Dylanfg123/Zebra-X/Pics/Zynq_Boot_Modes.png

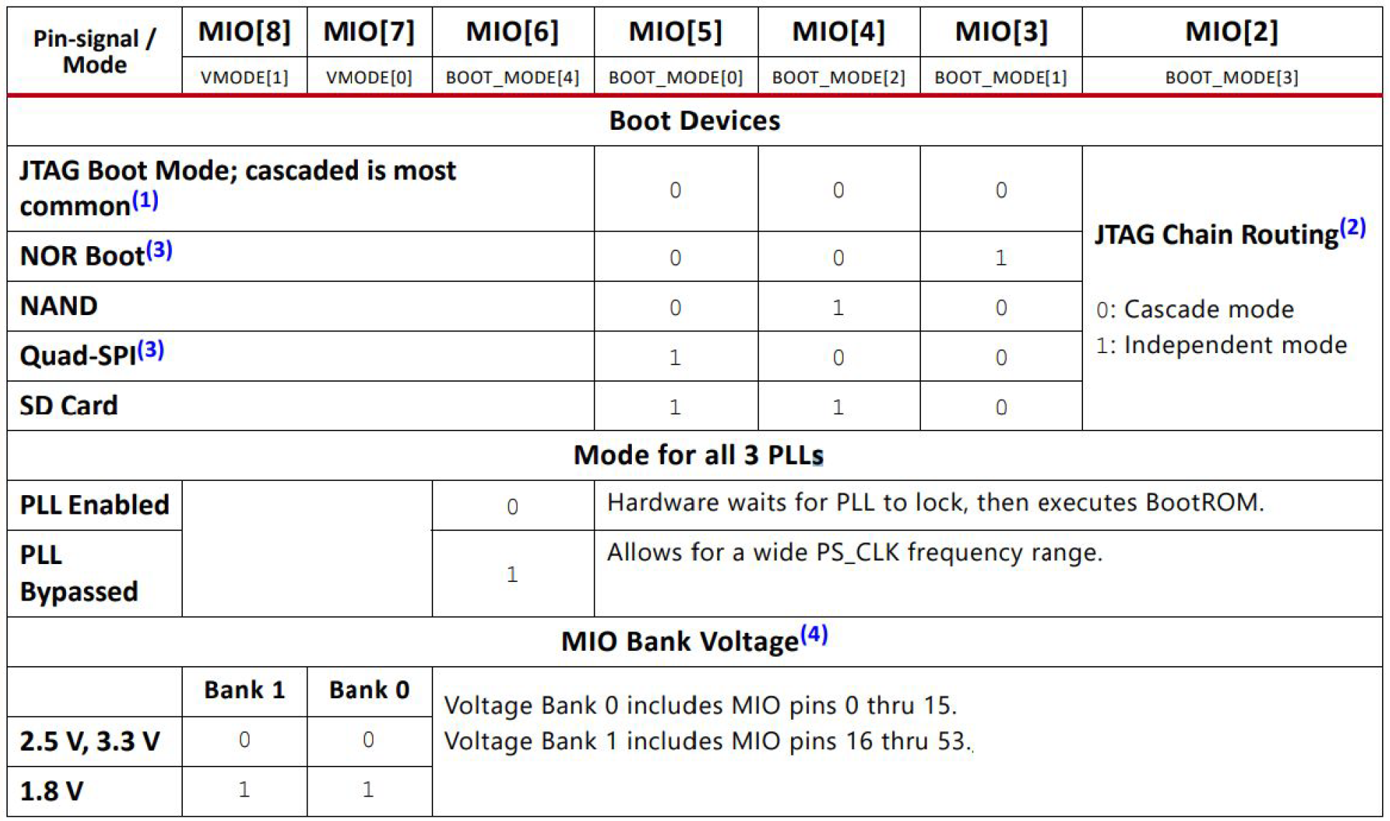
Pics/Zynq_Boot_Modes.png
