Dylanfg123/Zebra-X/Pics/Zynq_Required_PCB_Caps_PL.png

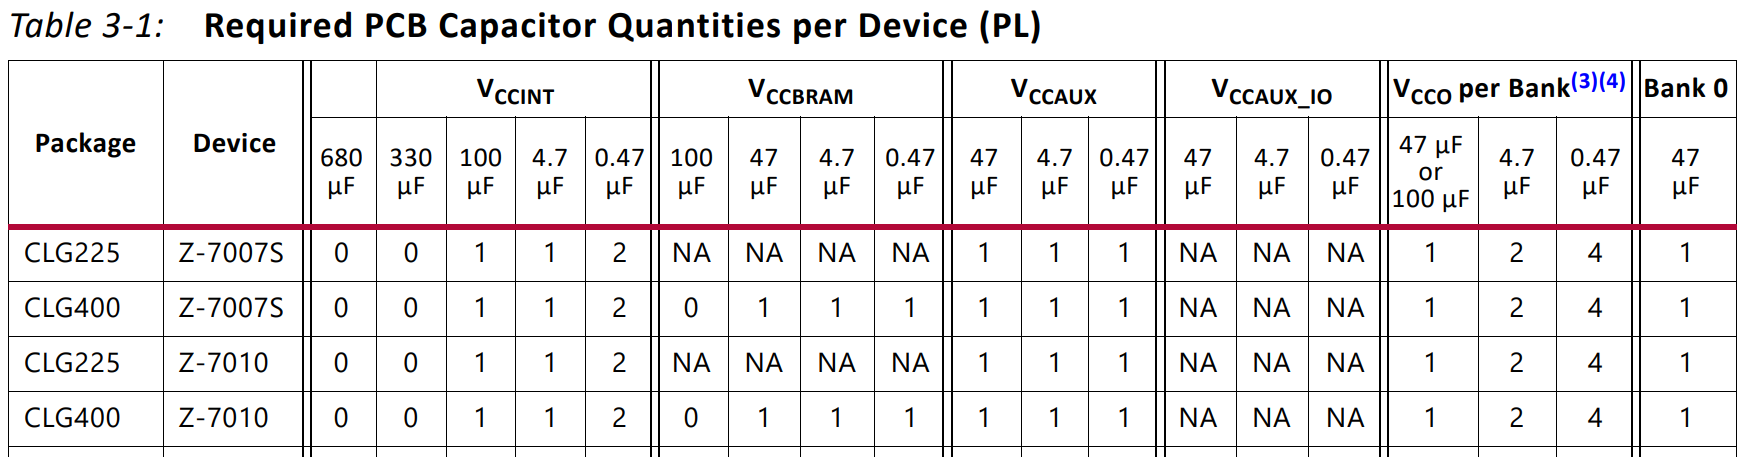
Pics/Zynq_Required_PCB_Caps_PL.png
