Dylanfg123/Zebra-X/Pics/Zynq_Required_PCB_Caps_PS.png

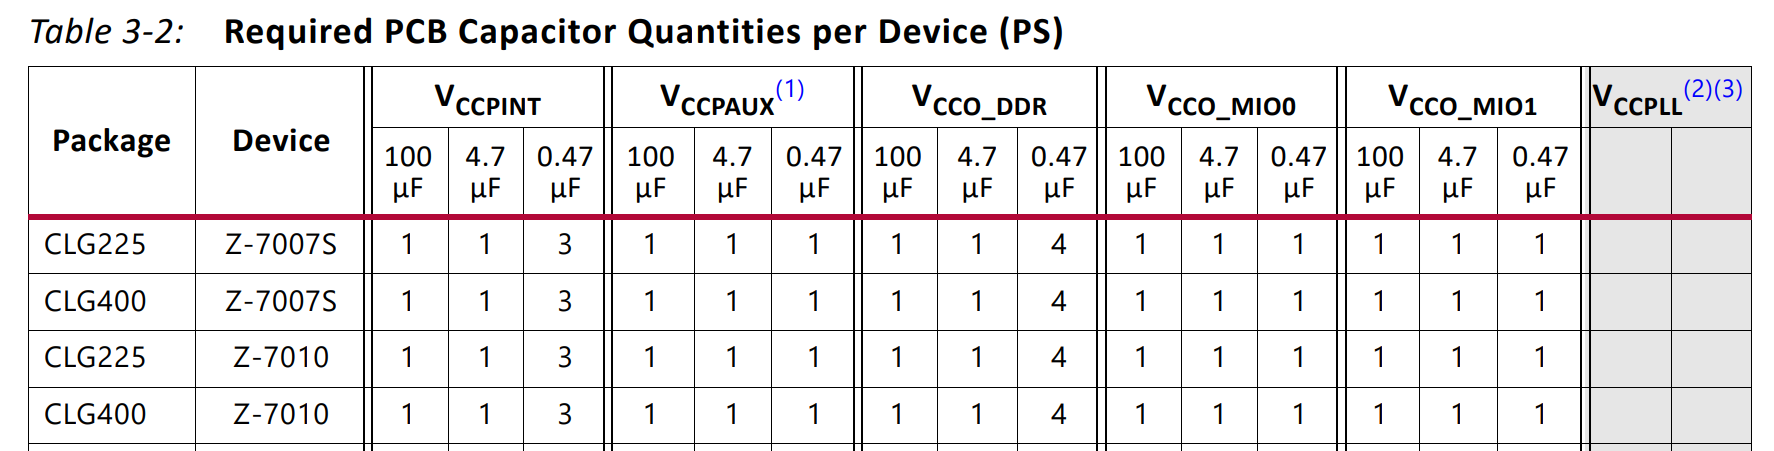
Pics/Zynq_Required_PCB_Caps_PS.png
