Dylanfg123/Zebra-X/3D_Models/GMSB0522132EU.stp

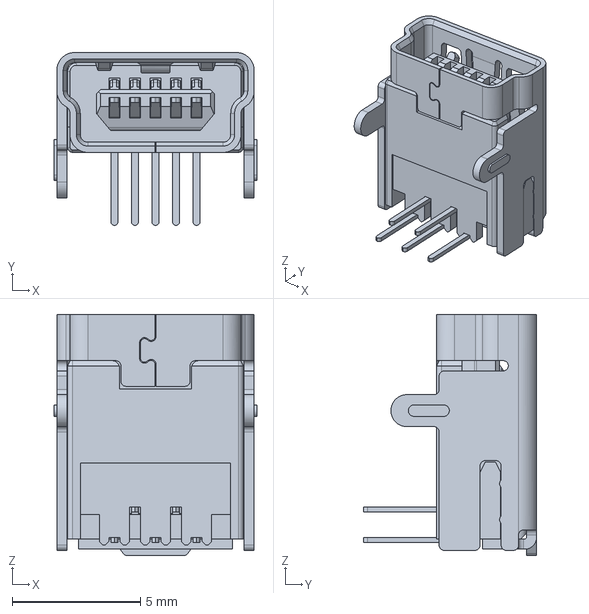
[picture p4: CAD file, 2025-01-19]
3D_Models/GMSB0522132EU.stp
7.90 x 6.75 x 9.40 mm
