Dylanfg123/Zebra-X/3D_Models/QFN32_5X5MC_MCH.step

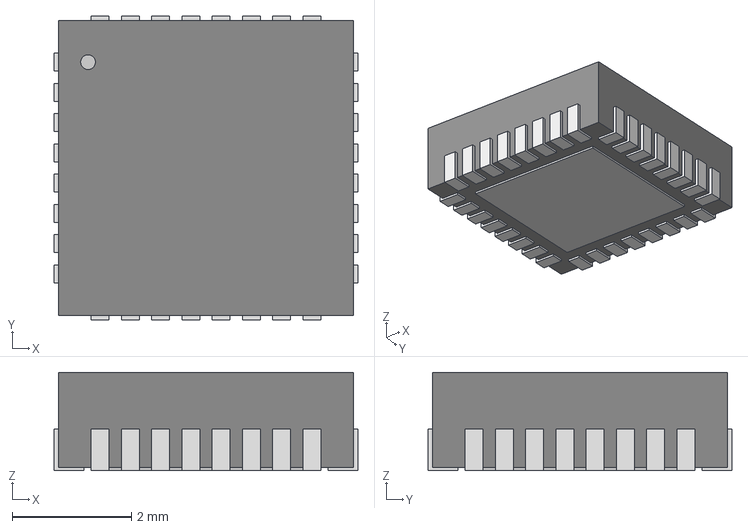
[picture p5: CAD file, 2025-01-18]
3D_Models/QFN32_5X5MC_MCH.step
5.11 x 5.11 x 1.65 mm
