Dylanfg123/Zebra-X/3D_Models/FBGA96_TW_MRN.step

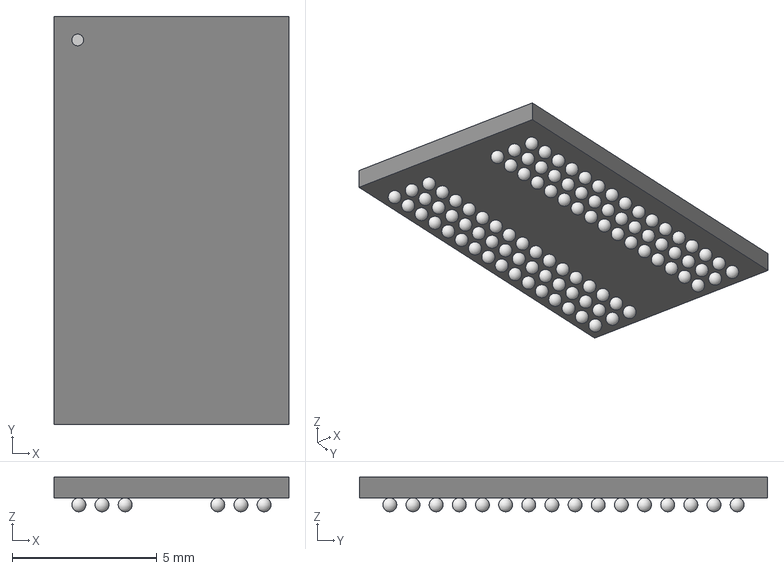
[picture p6: CAD file, 2024-08-24]
3D_Models/FBGA96_TW_MRN.step
8.10 x 14.1 x 1.20 mm
