Dylanfg123/Zebra-X/3D_Models/CLG400_XIL.step

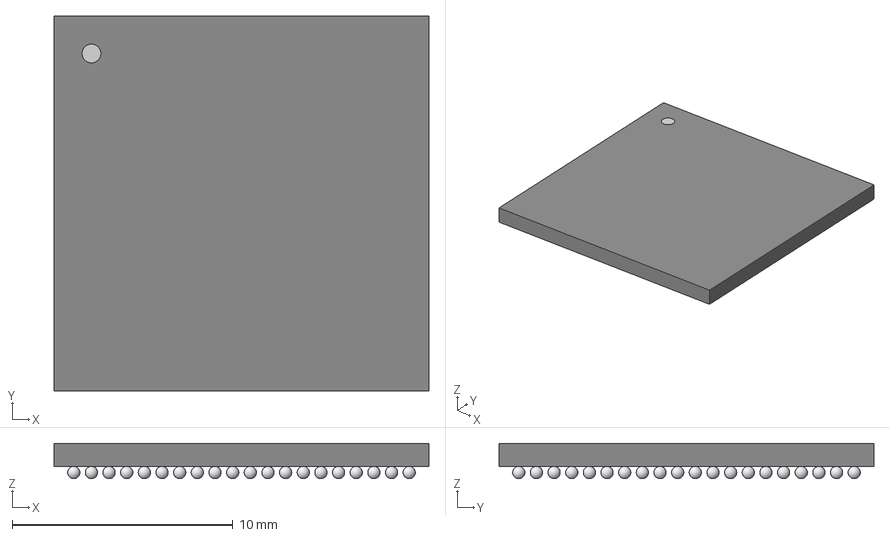
[picture p8: CAD file, 2023-12-10]
3D_Models/CLG400_XIL.step
17.0 x 17.0 x 1.60 mm
