Dylanfg123/Zebra-X/3D_Models/CON-SOCJ-2155--3DModel-STEP-56544.STEP

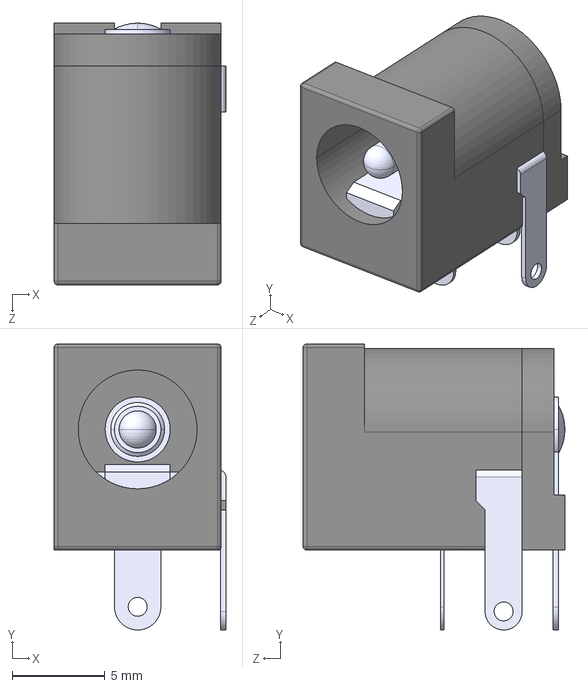
[picture p9: CAD file, 2023-12-10]
3D_Models/CON-SOCJ-2155--3DModel-STEP-56544.STEP
9.25 x 15.4 x 14.1 mm
