Dylanfg123/Zebra-X/3D_Models/10144518-082x0xxx.stp

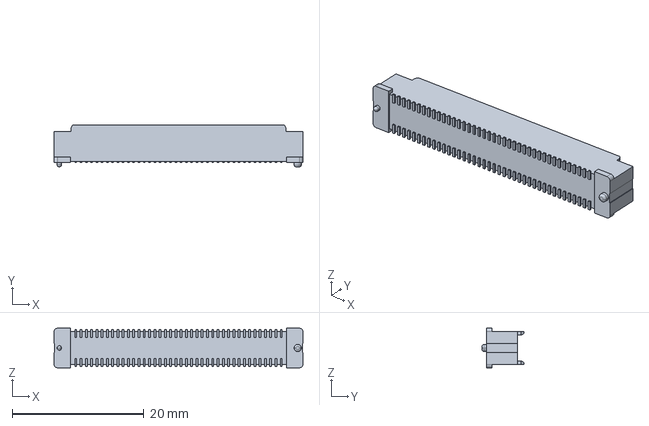
[picture p10: CAD file, 2025-01-22]
3D_Models/10144518-082x0xxx.stp
37.8 x 6.35 x 6.00 mm
