Dylanfg123/Zebra-X/3D_Models/HR911130A.step

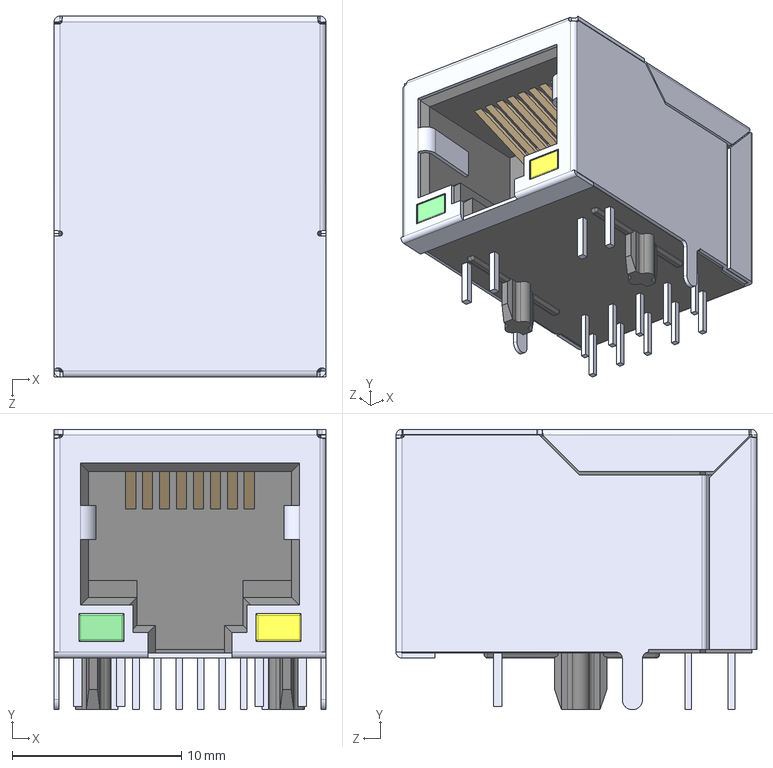
[picture p11: CAD file, 2025-01-18]
3D_Models/HR911130A.step
16.0 x 16.6 x 21.3 mm
