Dylanfg123/Zebra-X/ZeBra-X.kicad_pcb

## KiCad design ZeBra-X.kicad_pcb (2025-01-22)

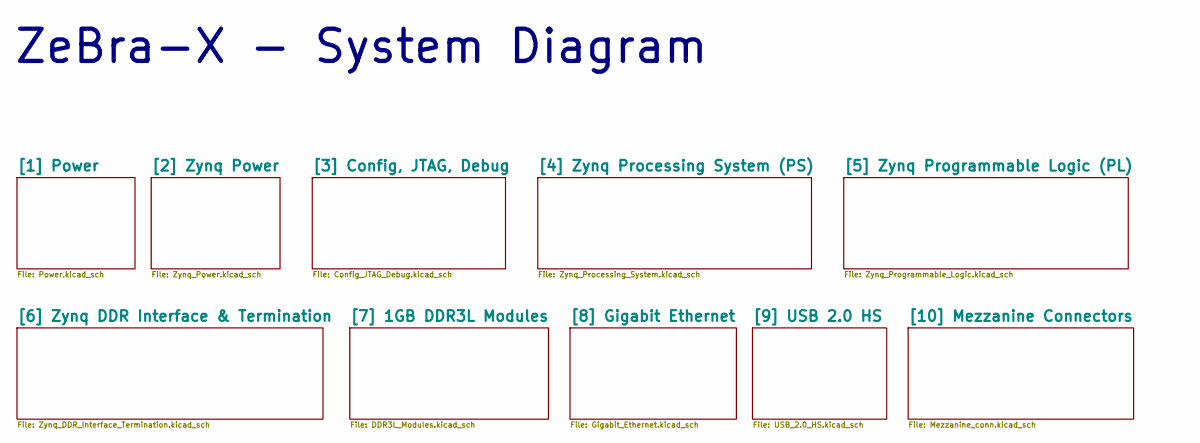
[picture p12: schematic ZeBra-X.kicad_sch, ZeBra-X: A Xilinx Zynq Demo Board]

Notes on the sheet:
ZeBra-X - System Diagram

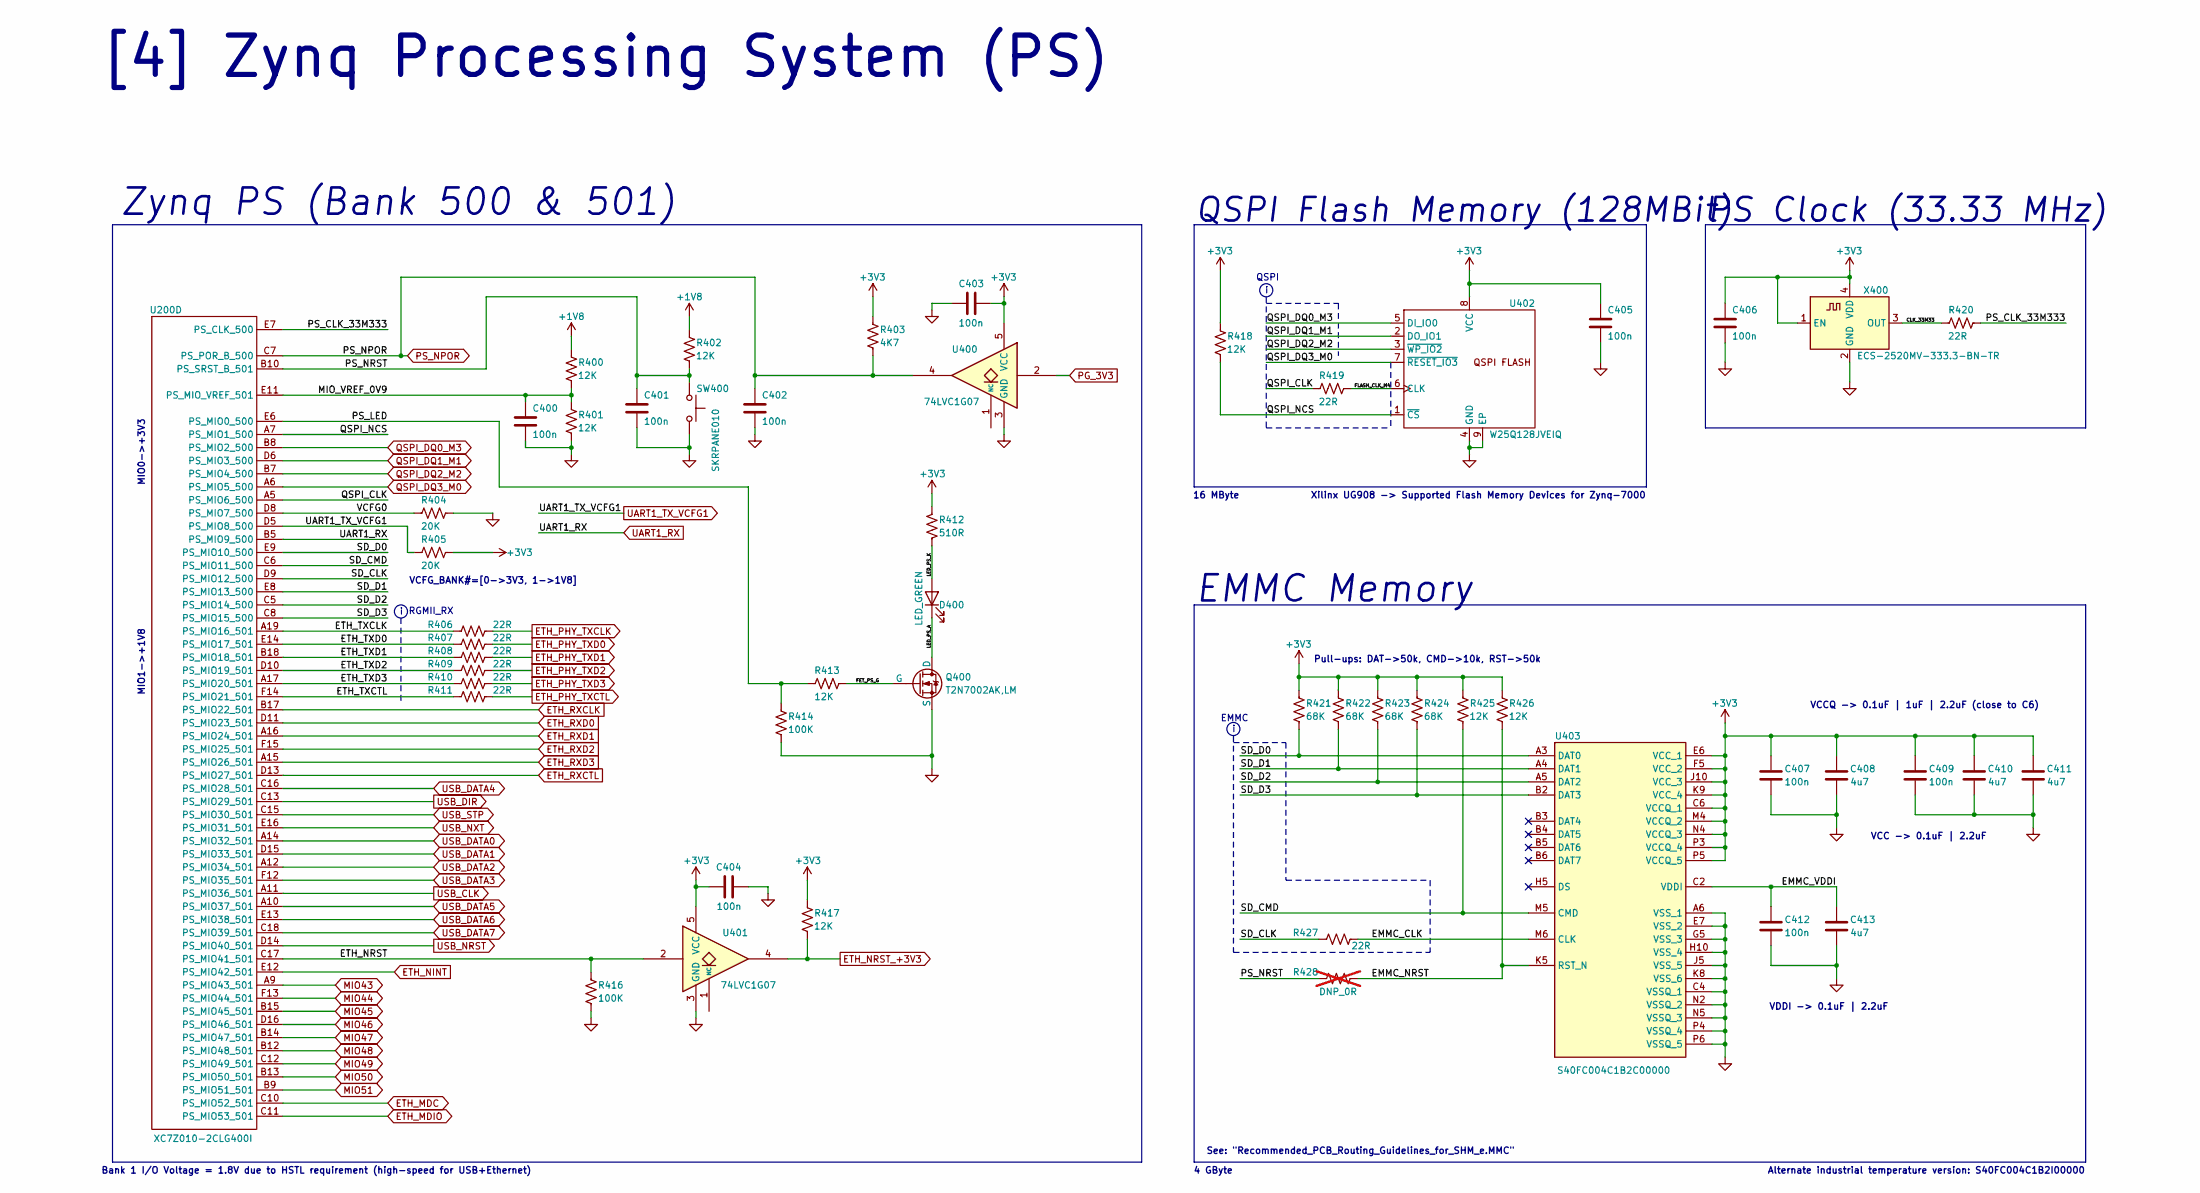
[picture p13: schematic Zynq_Processing_System.kicad_sch, Zynq Processing System]

Parts:
C400, C401, C402, C403, C404, C405, C406, C407, C409, C412: 100n; C_0402_1005Metric; Manufacturer PN CC0402KRX5R8BB104; LCSC PN C106256
C408, C410, C411, C413: 4u7; C_0402_1005Metric; Manufacturer PN CL05A475MP5NRNC; LCSC PN C23733
D400: LED_GREEN; LED_0402_1005Metric; Manufacturer PN SZYY0402YG; LCSC PN C434449
Q400: T2N7002AK,LM; SOT23_TOS; Manufacturer PN T2N7002AK,LM; LCSC PN C516175
R400, R401, R402, R413, R417, R418, R425, R426: 12K; R_0402_1005Metric; Manufacturer PN RTT021202FTH; LCSC PN C102781
R403: 4K7; R_0402_1005Metric; Manufacturer PN RC0402FR-074K7L; LCSC PN C105871
R404, R405: 20K; R_0402_1005Metric; Manufacturer PN RC0402FR-0720KL; LCSC PN C93942
R406, R407, R408, R409, R410, R411, R419, R420, R427: 22R; R_0402_1005Metric; Manufacturer PN RC0402FR-0722RL; LCSC PN C114765
R412: 510R; R_0402_1005Metric; Manufacturer PN RC0402FR-07510RL; LCSC PN C276273
R414, R416: 100K; R_0402_1005Metric; Manufacturer PN RC0402FR-07100KL; LCSC PN C60491
R421, R422, R423, R424: 68K; R_0402_1005Metric; Manufacturer PN RC0402FR-0768KL; LCSC PN C137947
R428: DNP_0R; R_0402_1005Metric; not fitted
SW400: SKRPANE010; SW_Push_1P1T_NO_Vertical_Wuerth_434133025816; Manufacturer PN SKRPANE010; LCSC PN C470426
U200: XC7Z010-2CLG400I; CLG400_XIL; Manufacturer PN XC7Z010-2CLG400I; LCSC PN C2840993
U400, U401: 74LVC1G07; SOT-23-5; Manufacturer PN SN74LVC1G07DBVT; LCSC PN C2867373
U402: W25Q128JVEIQ; WSON-8-1EP_8x6mm_P1.27mm_EP3.4x4.3mm; Manufacturer PN W25Q128JVEIQ
U403: S40FC004C1B2C00000; BGA153C50P14X14_900X750X80; Manufacturer PN S40FC004C1B2C00000
X400: ECS-2520MV-333.3-BN-TR; Oscillator_SMD_ECS_2520MV-xxx-xx-4Pin_2.5x2.0mm; Manufacturer PN ECS-2520MV-333.3-BN-TR

Connections:
+1V8: R400.2, R402.2; also elsewhere on the board
+3V3: C403.1, C404.1, C405.1, C406.1, C407.1, C408.2, C409.1, C410.2, C411.2, R403.1, R405.1, R412.2, R417.2, R418.2, R421.1, R422.1, R423.1, R424.1, R425.2, R426.2, U400.5 (VCC), U401.5 (VCC), U402.8 (VCC), U403.C6 (VCCQ_1), U403.E6 (VCC_1), U403.F5 (VCC_2), U403.J10 (VCC_3), U403.K9 (VCC_4), U403.M4 (VCCQ_2), U403.N4 (VCCQ_3), U403.P3 (VCCQ_4), U403.P5 (VCCQ_5), X400.1 (EN), X400.4 (VDD); also elsewhere on the board
/[4] Zynq Processing System (PS)/CLK_33M33: R420.1, X400.3 (OUT)
/[4] Zynq Processing System (PS)/EMMC_CLK: R427.2, U403.M6 (CLK)
/[4] Zynq Processing System (PS)/EMMC_NRST: R426.1, R428.1, U403.K5 (RST_N)
/[4] Zynq Processing System (PS)/EMMC_VDDI: C412.1, C413.2, U403.C2 (VDDI)
/[4] Zynq Processing System (PS)/ETH_NRST: R416.1, U200.C17 (PS_MIO41_501), U401.2
/[4] Zynq Processing System (PS)/ETH_TXCLK: R406.1, U200.A19 (PS_MIO16_501)
/[4] Zynq Processing System (PS)/ETH_TXCTL: R411.1, U200.F14 (PS_MIO21_501)
/[4] Zynq Processing System (PS)/ETH_TXD0: R407.1, U200.E14 (PS_MIO17_501)
/[4] Zynq Processing System (PS)/ETH_TXD1: R408.1, U200.B18 (PS_MIO18_501)
/[4] Zynq Processing System (PS)/ETH_TXD2: R409.1, U200.D10 (PS_MIO19_501)
/[4] Zynq Processing System (PS)/ETH_TXD3: R410.1, U200.A17 (PS_MIO20_501)
/[4] Zynq Processing System (PS)/FET_PS_G: Q400.1 (G), R413.1
/[4] Zynq Processing System (PS)/FLASH_CLK_M4: R419.2, U402.6 (CLK)
/[4] Zynq Processing System (PS)/LED_PS_A: D400.1 (K), Q400.3 (D)
/[4] Zynq Processing System (PS)/LED_PS_K: D400.2 (A), R412.1
/[4] Zynq Processing System (PS)/MIO_VREF_0V9: C400.1, R400.1, R401.2, U200.E11 (PS_MIO_VREF_501)
/[4] Zynq Processing System (PS)/PS_CLK_33M333: R420.2, U200.E7 (PS_CLK_500)
/[4] Zynq Processing System (PS)/PS_LED: R413.2, R414.1, U200.E6 (PS_MIO0_500)
/[4] Zynq Processing System (PS)/PS_NRST: C401.1, R402.1, R428.2, SW400.1, U200.B10 (PS_SRST_B_501)
/[4] Zynq Processing System (PS)/QSPI_CLK: R419.1, U200.A5 (PS_MIO6_500)
/[4] Zynq Processing System (PS)/QSPI_NCS: R418.1, U200.A7 (PS_MIO1_500), U402.1 (~CS)
/[4] Zynq Processing System (PS)/SD_CLK: R427.1, U200.D9 (PS_MIO12_500)
/[4] Zynq Processing System (PS)/SD_CMD: R425.1, U200.C6 (PS_MIO11_500), U403.M5 (CMD)
/[4] Zynq Processing System (PS)/SD_D0: R421.2, U200.E9 (PS_MIO10_500), U403.A3 (DAT0)
/[4] Zynq Processing System (PS)/SD_D1: R422.2, U200.E8 (PS_MIO13_500), U403.A4 (DAT1)
/[4] Zynq Processing System (PS)/SD_D2: R423.2, U200.C5 (PS_MIO14_500), U403.A5 (DAT2)
/[4] Zynq Processing System (PS)/SD_D3: R424.2, U200.C8 (PS_MIO15_500), U403.B2 (DAT3)
/[4] Zynq Processing System (PS)/VCFG0: R404.2, U200.D8 (PS_MIO7_500)
ETH_MDC: U200.C10 (PS_MIO52_501); also elsewhere on the board
ETH_MDIO: U200.C11 (PS_MIO53_501); also elsewhere on the board
ETH_NINT: U200.E12 (PS_MIO42_501); also elsewhere on the board
ETH_NRST_+3V3: R417.1, U401.4; also elsewhere on the board
ETH_PHY_TXCLK: R406.2; also elsewhere on the board
ETH_PHY_TXCTL: R411.2; also elsewhere on the board
ETH_PHY_TXD0: R407.2; also elsewhere on the board
ETH_PHY_TXD1: R408.2; also elsewhere on the board
ETH_PHY_TXD2: R409.2; also elsewhere on the board
ETH_PHY_TXD3: R410.2; also elsewhere on the board
ETH_RXCLK: U200.B17 (PS_MIO22_501); also elsewhere on the board
ETH_RXCTL: U200.D13 (PS_MIO27_501); also elsewhere on the board
ETH_RXD0: U200.D11 (PS_MIO23_501); also elsewhere on the board
ETH_RXD1: U200.A16 (PS_MIO24_501); also elsewhere on the board
ETH_RXD2: U200.F15 (PS_MIO25_501); also elsewhere on the board
ETH_RXD3: U200.A15 (PS_MIO26_501); also elsewhere on the board
GND: C400.2, C401.2, C402.2, C403.2, C404.2, C405.2, C406.2, C407.2, C408.1, C409.2, C410.1, C411.1, C412.2, C413.1, Q400.2 (S), R401.1, R404.1, R414.2, R416.2, SW400.2, U400.3 (GND), U401.3 (GND), U402.4 (GND), U402.9 (EP), U403.A6 (VSS_1), U403.C4 (VSSQ_1), U403.E7 (VSS_2), U403.G5 (VSS_3), U403.H10 (VSS_4), U403.J5 (VSS_5), U403.K8 (VSS_6), U403.N2 (VSSQ_2), U403.N5 (VSSQ_3), U403.P4 (VSSQ_4), U403.P6 (VSSQ_5), X400.2 (GND); also elsewhere on the board
MIO43: U200.A9 (PS_MIO43_501)
MIO44: U200.F13 (PS_MIO44_501)
MIO45: U200.B15 (PS_MIO45_501)
MIO46: U200.D16 (PS_MIO46_501)
MIO47: U200.B14 (PS_MIO47_501)
MIO48: U200.B12 (PS_MIO48_501)
MIO49: U200.C12 (PS_MIO49_501); also elsewhere on the board
MIO50: U200.B13 (PS_MIO50_501); also elsewhere on the board
MIO51: U200.B9 (PS_MIO51_501); also elsewhere on the board
PG_3V3: U400.2; also elsewhere on the board
PS_NPOR: C402.1, R403.2, U200.C7 (PS_POR_B_500), U400.4; also elsewhere on the board
QSPI_DQ0_M3: U200.B8 (PS_MIO2_500), U402.5 (DI_IO0); also elsewhere on the board
QSPI_DQ1_M1: U200.D6 (PS_MIO3_500), U402.2 (DO_IO1); also elsewhere on the board
QSPI_DQ2_M2: U200.B7 (PS_MIO4_500), U402.3 (~WP_IO2); also elsewhere on the board
QSPI_DQ3_M0: U200.A6 (PS_MIO5_500), U402.7 (~RESET_IO3); also elsewhere on the board
UART1_RX: U200.B5 (PS_MIO9_500); also elsewhere on the board
UART1_TX_VCFG1: R405.2, U200.D5 (PS_MIO8_500); also elsewhere on the board
USB_CLK: U200.A11 (PS_MIO36_501); also elsewhere on the board
USB_DATA0: U200.A14 (PS_MIO32_501); also elsewhere on the board
USB_DATA1: U200.D15 (PS_MIO33_501); also elsewhere on the board
USB_DATA2: U200.A12 (PS_MIO34_501); also elsewhere on the board
USB_DATA3: U200.F12 (PS_MIO35_501); also elsewhere on the board
USB_DATA4: U200.C16 (PS_MIO28_501); also elsewhere on the board
USB_DATA5: U200.A10 (PS_MIO37_501); also elsewhere on the board
USB_DATA6: U200.E13 (PS_MIO38_501); also elsewhere on the board
USB_DATA7: U200.C18 (PS_MIO39_501); also elsewhere on the board
USB_DIR: U200.C13 (PS_MIO29_501); also elsewhere on the board
USB_NRST: U200.D14 (PS_MIO40_501); also elsewhere on the board
USB_NXT: U200.E16 (PS_MIO31_501); also elsewhere on the board
USB_STP: U200.C15 (PS_MIO30_501); also elsewhere on the board

Notes on the sheet:
VCFG_BANK#=[0->3V3, 1->1V8]
16 MByte
See: "Recommended_PCB_Routing_Guidelines_for_SHM_e.MMC"
EMMC Memory
MIO1->+1V8
Xilinx UG908 -> Supported Flash Memory Devices for Zynq-7000
VDDI -> 0.1uF | 2.2uF
VCC -> 0.1uF | 2.2uF
Zynq PS (Bank 500 & 501)
RGMII_RX
QSPI
Alternate industrial temperature version: S40FC004C1B2I00000
Pull-ups: DAT->50k, CMD->10k, RST->50k
VCCQ -> 0.1uF | 1uF | 2.2uF (close to C6)
Bank 1 I/O Voltage = 1.8V due to HSTL requirement (high-speed for USB+Ethernet)
EMMC
4 GByte
QSPI Flash Memory (128MBit)
[4] Zynq Processing System (PS)
PS Clock (33.33 MHz)
MIO0->+3V3

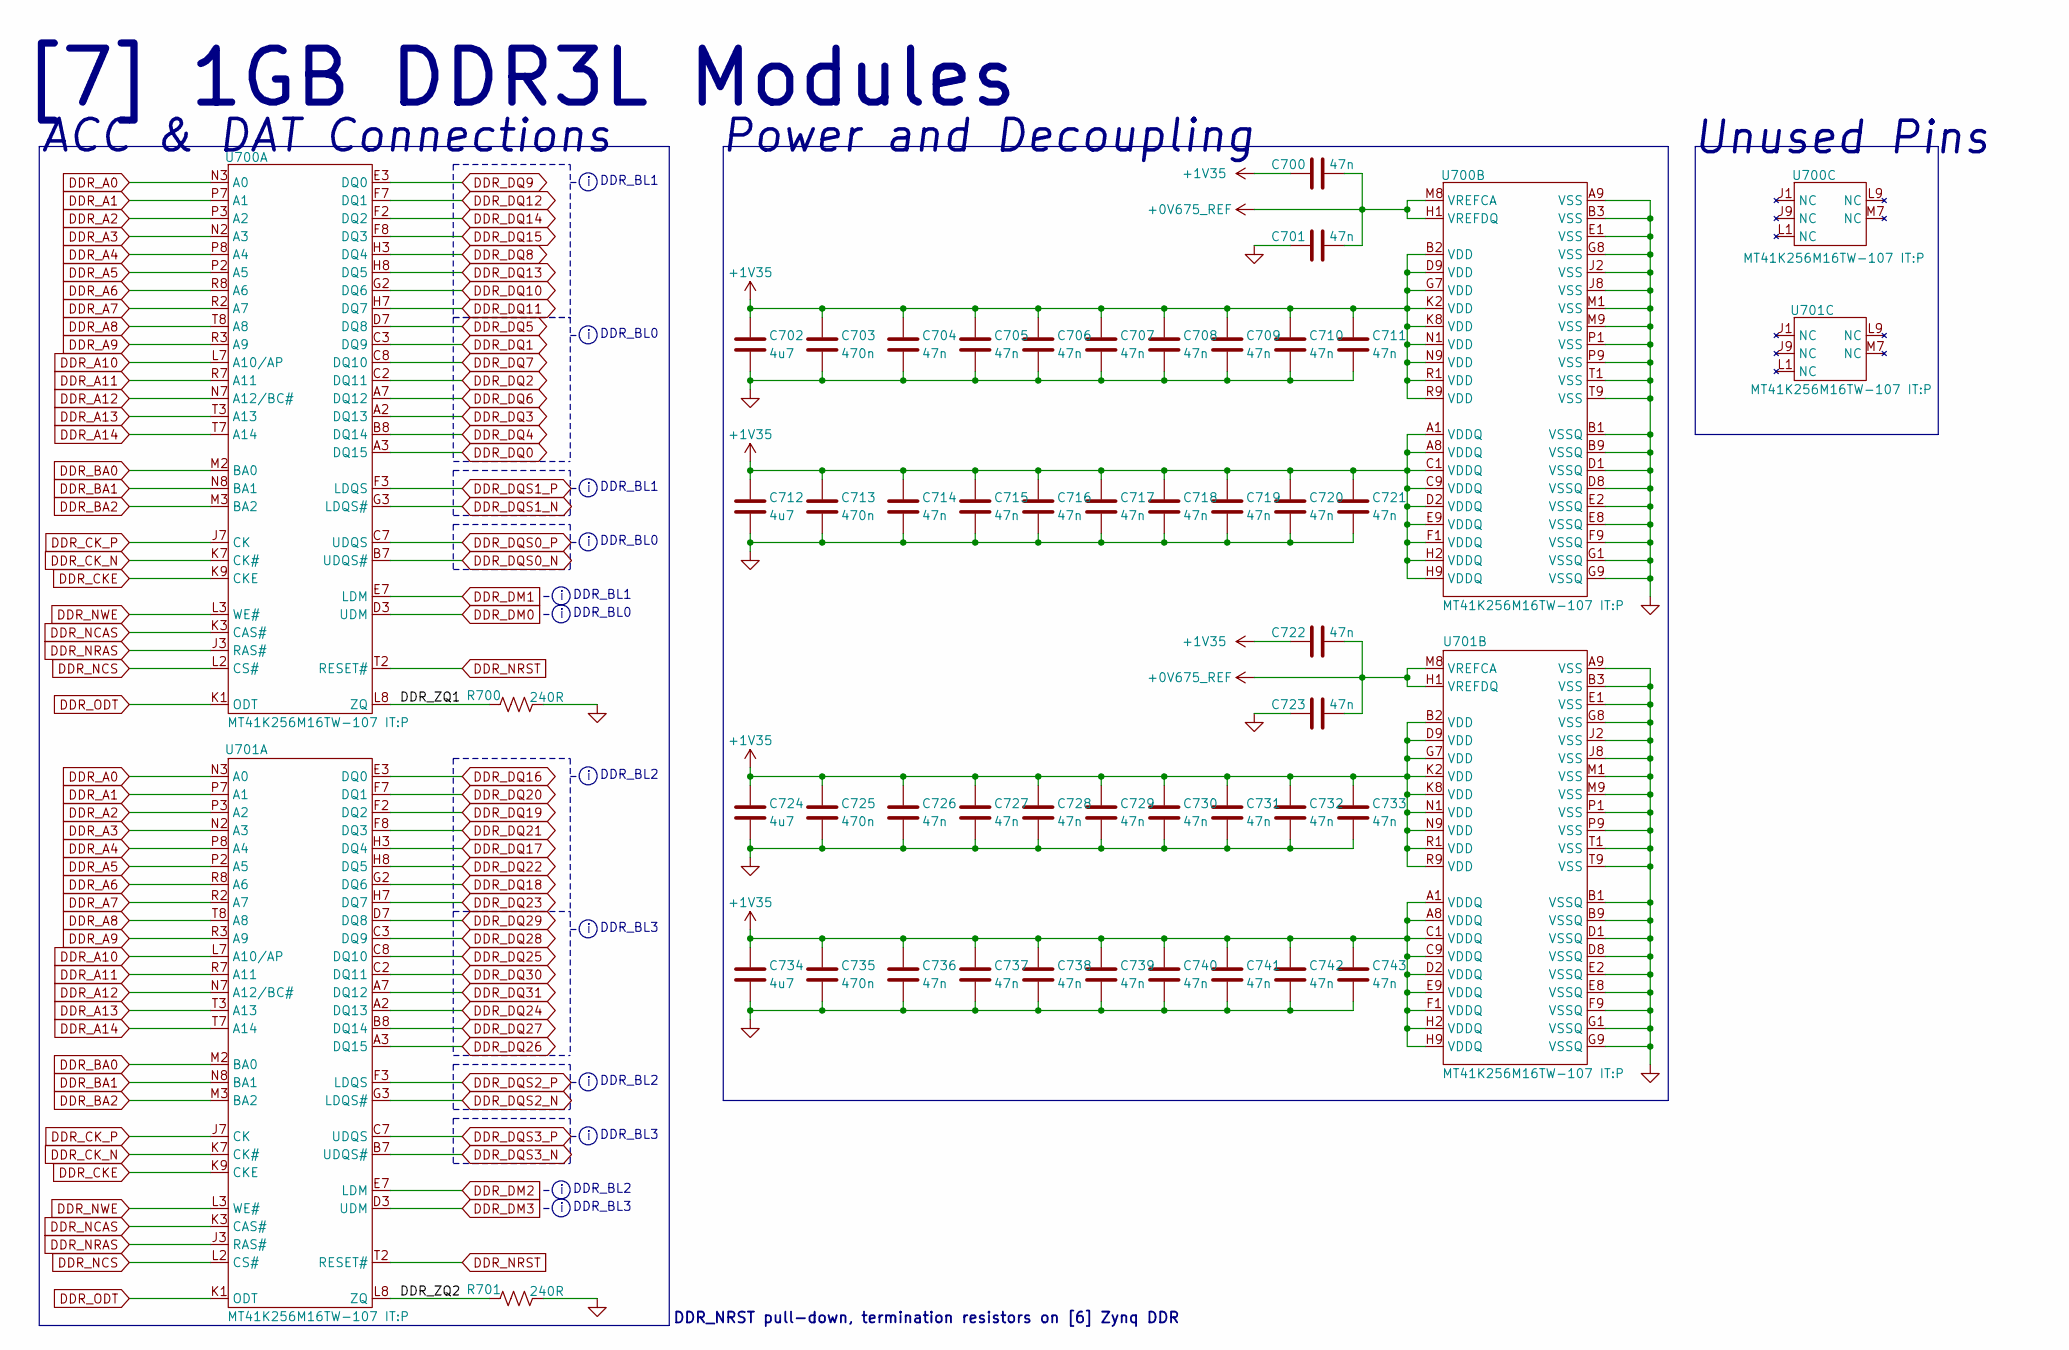
[picture p14: schematic DDR3L_Modules.kicad_sch, DDR3L Modules]

Parts:
C700, C701, C704, C705, C706, C707, C708, C709, C710, C711, C714, C715, C716, C717, C718, C719, C720, C721, C722, C723, C726, C727, C728, C729, C730, C731, C732, C733, C736, C737, C738, C739, C740, C741, C742, C743: 47n; C_0201_0603Metric; Manufacturer PN GRT033R60J473KE01D; LCSC PN C126621
C702, C712, C724, C734: 4u7; C_0402_1005Metric; Manufacturer PN CL05A475MP5NRNC; LCSC PN C23733
C703, C713, C725, C735: 470n; C_0201_0603Metric; Manufacturer PN GRM033R60J474KE90D; LCSC PN C85926
R700, R701: 240R; R_0402_1005Metric; Manufacturer PN RC0402FR-07240RL; LCSC PN C114755
U700, U701: MT41K256M16TW-107 IT:P; FBGA96_TW_MRN; Manufacturer PN MT41K256M16TW-107 IT:P; LCSC PN C367428

Connections:
+0V675_REF: C700.2, C701.2, C722.2, C723.2, U700.H1 (VREFDQ), U700.M8 (VREFCA), U701.H1 (VREFDQ), U701.M8 (VREFCA); also elsewhere on the board
+1V35: C700.1, C702.1, C703.1, C704.1, C705.1, C706.1, C707.1, C708.1, C709.1, C710.1, C711.1, C712.1, C713.1, C714.1, C715.1, C716.1, C717.1, C718.1, C719.1, C720.1, C721.1, C722.1, C724.1, C725.1, C726.1, C727.1, C728.1, C729.1, C730.1, C731.1, C732.1, C733.1, C734.1, C735.1, C736.1, C737.1, C738.1, C739.1, C740.1, C741.1, C742.1, C743.1, U700.A1 (VDDQ), U700.A8 (VDDQ), U700.B2 (VDD), U700.C1 (VDDQ), U700.C9 (VDDQ), U700.D2 (VDDQ), U700.D9 (VDD), U700.E9 (VDDQ), U700.F1 (VDDQ), U700.G7 (VDD), U700.H2 (VDDQ), U700.H9 (VDDQ), U700.K2 (VDD), U700.K8 (VDD), U700.N1 (VDD), U700.N9 (VDD), U700.R1 (VDD), U700.R9 (VDD), U701.A1 (VDDQ), U701.A8 (VDDQ), U701.B2 (VDD), U701.C1 (VDDQ), U701.C9 (VDDQ), U701.D2 (VDDQ), U701.D9 (VDD), U701.E9 (VDDQ), U701.F1 (VDDQ), U701.G7 (VDD), U701.H2 (VDDQ), U701.H9 (VDDQ), U701.K2 (VDD), U701.K8 (VDD), U701.N1 (VDD), U701.N9 (VDD), U701.R1 (VDD), U701.R9 (VDD); also elsewhere on the board
/[7] 1GB DDR3L Modules/DDR_ZQ1: R700.1, U700.L8 (ZQ)
/[7] 1GB DDR3L Modules/DDR_ZQ2: R701.1, U701.L8 (ZQ)
DDR_A0: U700.N3 (A0), U701.N3 (A0); also elsewhere on the board
DDR_A1: U700.P7 (A1), U701.P7 (A1); also elsewhere on the board
DDR_A2: U700.P3 (A2), U701.P3 (A2); also elsewhere on the board
DDR_A3: U700.N2 (A3), U701.N2 (A3); also elsewhere on the board
DDR_A4: U700.P8 (A4), U701.P8 (A4); also elsewhere on the board
DDR_A5: U700.P2 (A5), U701.P2 (A5); also elsewhere on the board
DDR_A6: U700.R8 (A6), U701.R8 (A6); also elsewhere on the board
DDR_A7: U700.R2 (A7), U701.R2 (A7); also elsewhere on the board
DDR_A8: U700.T8 (A8), U701.T8 (A8); also elsewhere on the board
DDR_A9: U700.R3 (A9), U701.R3 (A9); also elsewhere on the board
DDR_A10: U700.L7 (A10/AP), U701.L7 (A10/AP); also elsewhere on the board
DDR_A11: U700.R7 (A11), U701.R7 (A11); also elsewhere on the board
DDR_A12: U700.N7 (A12/BC#), U701.N7 (A12/BC#); also elsewhere on the board
DDR_A13: U700.T3 (A13), U701.T3 (A13); also elsewhere on the board
DDR_A14: U700.T7 (A14), U701.T7 (A14); also elsewhere on the board
DDR_BA0: U700.M2 (BA0), U701.M2 (BA0); also elsewhere on the board
DDR_BA1: U700.N8 (BA1), U701.N8 (BA1); also elsewhere on the board
DDR_BA2: U700.M3 (BA2), U701.M3 (BA2); also elsewhere on the board
DDR_CKE: U700.K9 (CKE), U701.K9 (CKE); also elsewhere on the board
DDR_CK_N: U700.K7 (CK#), U701.K7 (CK#); also elsewhere on the board
DDR_CK_P: U700.J7 (CK), U701.J7 (CK); also elsewhere on the board
DDR_DM0: U700.D3 (UDM); also elsewhere on the board
DDR_DM1: U700.E7 (LDM); also elsewhere on the board
DDR_DM2: U701.E7 (LDM); also elsewhere on the board
DDR_DM3: U701.D3 (UDM); also elsewhere on the board
DDR_DQ0: U700.A3 (DQ15); also elsewhere on the board
DDR_DQ1: U700.C3 (DQ9); also elsewhere on the board
DDR_DQ2: U700.C2 (DQ11); also elsewhere on the board
DDR_DQ3: U700.A2 (DQ13); also elsewhere on the board
DDR_DQ4: U700.B8 (DQ14); also elsewhere on the board
DDR_DQ5: U700.D7 (DQ8); also elsewhere on the board
DDR_DQ6: U700.A7 (DQ12); also elsewhere on the board
DDR_DQ7: U700.C8 (DQ10); also elsewhere on the board
DDR_DQ8: U700.H3 (DQ4); also elsewhere on the board
DDR_DQ9: U700.E3 (DQ0); also elsewhere on the board
DDR_DQ10: U700.G2 (DQ6); also elsewhere on the board
DDR_DQ11: U700.H7 (DQ7); also elsewhere on the board
DDR_DQ12: U700.F7 (DQ1); also elsewhere on the board
DDR_DQ13: U700.H8 (DQ5); also elsewhere on the board
DDR_DQ14: U700.F2 (DQ2); also elsewhere on the board
DDR_DQ15: U700.F8 (DQ3); also elsewhere on the board
DDR_DQ16: U701.E3 (DQ0); also elsewhere on the board
DDR_DQ17: U701.H3 (DQ4); also elsewhere on the board
DDR_DQ18: U701.G2 (DQ6); also elsewhere on the board
DDR_DQ19: U701.F2 (DQ2); also elsewhere on the board
DDR_DQ20: U701.F7 (DQ1); also elsewhere on the board
DDR_DQ21: U701.F8 (DQ3); also elsewhere on the board
DDR_DQ22: U701.H8 (DQ5); also elsewhere on the board
DDR_DQ23: U701.H7 (DQ7); also elsewhere on the board
DDR_DQ24: U701.A2 (DQ13); also elsewhere on the board
DDR_DQ25: U701.C8 (DQ10); also elsewhere on the board
DDR_DQ26: U701.A3 (DQ15); also elsewhere on the board
DDR_DQ27: U701.B8 (DQ14); also elsewhere on the board
DDR_DQ28: U701.C3 (DQ9); also elsewhere on the board
DDR_DQ29: U701.D7 (DQ8); also elsewhere on the board
DDR_DQ30: U701.C2 (DQ11); also elsewhere on the board
DDR_DQ31: U701.A7 (DQ12); also elsewhere on the board
DDR_DQS0_N: U700.B7 (UDQS#); also elsewhere on the board
DDR_DQS0_P: U700.C7 (UDQS); also elsewhere on the board
DDR_DQS1_N: U700.G3 (LDQS#); also elsewhere on the board
DDR_DQS1_P: U700.F3 (LDQS); also elsewhere on the board
DDR_DQS2_N: U701.G3 (LDQS#); also elsewhere on the board
DDR_DQS2_P: U701.F3 (LDQS); also elsewhere on the board
DDR_DQS3_N: U701.B7 (UDQS#); also elsewhere on the board
DDR_DQS3_P: U701.C7 (UDQS); also elsewhere on the board
DDR_NCAS: U700.K3 (CAS#), U701.K3 (CAS#); also elsewhere on the board
DDR_NCS: U700.L2 (CS#), U701.L2 (CS#); also elsewhere on the board
DDR_NRAS: U700.J3 (RAS#), U701.J3 (RAS#); also elsewhere on the board
DDR_NRST: U700.T2 (RESET#), U701.T2 (RESET#); also elsewhere on the board
DDR_NWE: U700.L3 (WE#), U701.L3 (WE#); also elsewhere on the board
DDR_ODT: U700.K1 (ODT), U701.K1 (ODT); also elsewhere on the board
GND: C701.1, C702.2, C703.2, C704.2, C705.2, C706.2, C707.2, C708.2, C709.2, C710.2, C711.2, C712.2, C713.2, C714.2, C715.2, C716.2, C717.2, C718.2, C719.2, C720.2, C721.2, C723.1, C724.2, C725.2, C726.2, C727.2, C728.2, C729.2, C730.2, C731.2, C732.2, C733.2, C734.2, C735.2, C736.2, C737.2, C738.2, C739.2, C740.2, C741.2, C742.2, C743.2, R700.2, R701.2, U700.A9 (VSS), U700.B1 (VSSQ), U700.B3 (VSS), U700.B9 (VSSQ), U700.D1 (VSSQ), U700.D8 (VSSQ), U700.E1 (VSS), U700.E2 (VSSQ), U700.E8 (VSSQ), U700.F9 (VSSQ), U700.G1 (VSSQ), U700.G8 (VSS), U700.G9 (VSSQ), U700.J2 (VSS), U700.J8 (VSS), U700.M1 (VSS), U700.M9 (VSS), U700.P1 (VSS), U700.P9 (VSS), U700.T1 (VSS), U700.T9 (VSS), U701.A9 (VSS), U701.B1 (VSSQ), U701.B3 (VSS), U701.B9 (VSSQ), U701.D1 (VSSQ), U701.D8 (VSSQ), U701.E1 (VSS), U701.E2 (VSSQ), U701.E8 (VSSQ), U701.F9 (VSSQ), U701.G1 (VSSQ), U701.G8 (VSS), U701.G9 (VSSQ), U701.J2 (VSS), U701.J8 (VSS), U701.M1 (VSS), U701.M9 (VSS), U701.P1 (VSS), U701.P9 (VSS), U701.T1 (VSS), U701.T9 (VSS); also elsewhere on the board

Notes on the sheet:
DDR_BL2
DDR_BL0
ACC & DAT Connections
DDR_BL3
DDR_BL1
Unused Pins
[7] 1GB DDR3L Modules
DDR_NRST pull-down, termination resistors on [6] Zynq DDR
Power and Decoupling
DDR_BL1

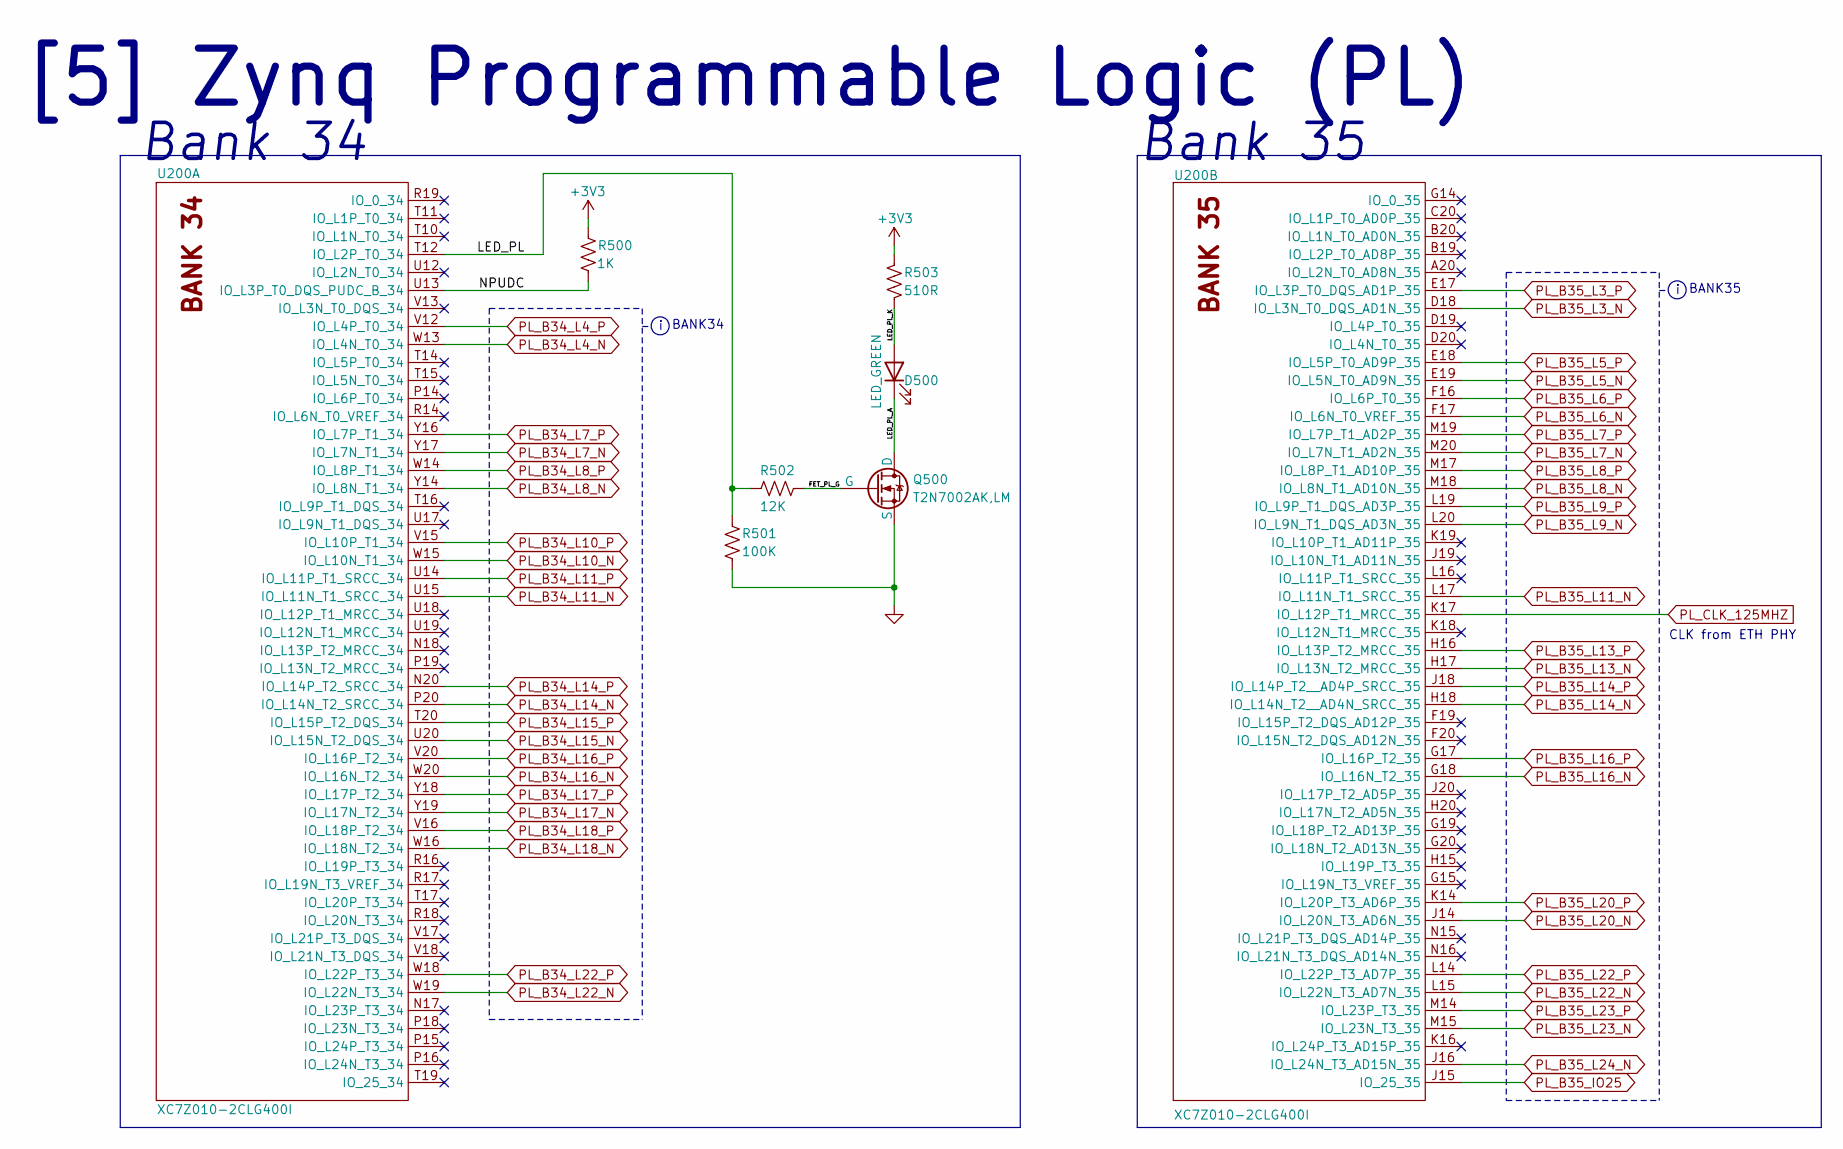
[picture p15: schematic Zynq_Programmable_Logic.kicad_sch, Zynq Programmable Logic]

Parts:
D500: LED_GREEN; LED_0402_1005Metric; Manufacturer PN SZYY0402YG; LCSC PN C434449
Q500: T2N7002AK,LM; SOT23_TOS; Manufacturer PN T2N7002AK,LM; LCSC PN C516175
R500: 1K; R_0402_1005Metric; Manufacturer PN RC0402FR-071KL; LCSC PN C106235
R501: 100K; R_0402_1005Metric; Manufacturer PN RC0402FR-07100KL; LCSC PN C60491
R502: 12K; R_0402_1005Metric; Manufacturer PN RTT021202FTH; LCSC PN C102781
R503: 510R; R_0402_1005Metric; Manufacturer PN RC0402FR-07510RL; LCSC PN C276273
U200: XC7Z010-2CLG400I; CLG400_XIL; Manufacturer PN XC7Z010-2CLG400I; LCSC PN C2840993

Connections:
+3V3: R500.2, R503.2; also elsewhere on the board
/[5] Zynq Programmable Logic (PL)/FET_PL_G: Q500.1 (G), R502.1
/[5] Zynq Programmable Logic (PL)/LED_PL: R501.1, R502.2, U200.T12 (IO_L2P_T0_34)
/[5] Zynq Programmable Logic (PL)/LED_PL_A: D500.1 (K), Q500.3 (D)
/[5] Zynq Programmable Logic (PL)/LED_PL_K: D500.2 (A), R503.1
/[5] Zynq Programmable Logic (PL)/NPUDC: R500.1, U200.U13 (IO_L3P_T0_DQS_PUDC_B_34)
GND: Q500.2 (S), R501.2; also elsewhere on the board
PL_B34_L4_N: U200.W13 (IO_L4N_T0_34); also elsewhere on the board
PL_B34_L4_P: U200.V12 (IO_L4P_T0_34); also elsewhere on the board
PL_B34_L7_N: U200.Y17 (IO_L7N_T1_34); also elsewhere on the board
PL_B34_L7_P: U200.Y16 (IO_L7P_T1_34); also elsewhere on the board
PL_B34_L8_N: U200.Y14 (IO_L8N_T1_34); also elsewhere on the board
PL_B34_L8_P: U200.W14 (IO_L8P_T1_34); also elsewhere on the board
PL_B34_L10_N: U200.W15 (IO_L10N_T1_34); also elsewhere on the board
PL_B34_L10_P: U200.V15 (IO_L10P_T1_34); also elsewhere on the board
PL_B34_L11_N: U200.U15 (IO_L11N_T1_SRCC_34); also elsewhere on the board
PL_B34_L11_P: U200.U14 (IO_L11P_T1_SRCC_34); also elsewhere on the board
PL_B34_L14_N: U200.P20 (IO_L14N_T2_SRCC_34); also elsewhere on the board
PL_B34_L14_P: U200.N20 (IO_L14P_T2_SRCC_34); also elsewhere on the board
PL_B34_L15_N: U200.U20 (IO_L15N_T2_DQS_34); also elsewhere on the board
PL_B34_L15_P: U200.T20 (IO_L15P_T2_DQS_34); also elsewhere on the board
PL_B34_L16_N: U200.W20 (IO_L16N_T2_34); also elsewhere on the board
PL_B34_L16_P: U200.V20 (IO_L16P_T2_34); also elsewhere on the board
PL_B34_L17_N: U200.Y19 (IO_L17N_T2_34); also elsewhere on the board
PL_B34_L17_P: U200.Y18 (IO_L17P_T2_34); also elsewhere on the board
PL_B34_L18_N: U200.W16 (IO_L18N_T2_34); also elsewhere on the board
PL_B34_L18_P: U200.V16 (IO_L18P_T2_34); also elsewhere on the board
PL_B34_L22_N: U200.W19 (IO_L22N_T3_34); also elsewhere on the board
PL_B34_L22_P: U200.W18 (IO_L22P_T3_34); also elsewhere on the board
PL_B35_IO25: U200.J15 (IO_25_35); also elsewhere on the board
PL_B35_L3_N: U200.D18 (IO_L3N_T0_DQS_AD1N_35); also elsewhere on the board
PL_B35_L3_P: U200.E17 (IO_L3P_T0_DQS_AD1P_35); also elsewhere on the board
PL_B35_L5_N: U200.E19 (IO_L5N_T0_AD9N_35); also elsewhere on the board
PL_B35_L5_P: U200.E18 (IO_L5P_T0_AD9P_35); also elsewhere on the board
PL_B35_L6_N: U200.F17 (IO_L6N_T0_VREF_35); also elsewhere on the board
PL_B35_L6_P: U200.F16 (IO_L6P_T0_35); also elsewhere on the board
PL_B35_L7_N: U200.M20 (IO_L7N_T1_AD2N_35); also elsewhere on the board
PL_B35_L7_P: U200.M19 (IO_L7P_T1_AD2P_35); also elsewhere on the board
PL_B35_L8_N: U200.M18 (IO_L8N_T1_AD10N_35); also elsewhere on the board
PL_B35_L8_P: U200.M17 (IO_L8P_T1_AD10P_35); also elsewhere on the board
PL_B35_L9_N: U200.L20 (IO_L9N_T1_DQS_AD3N_35); also elsewhere on the board
PL_B35_L9_P: U200.L19 (IO_L9P_T1_DQS_AD3P_35); also elsewhere on the board
PL_B35_L11_N: U200.L17 (IO_L11N_T1_SRCC_35); also elsewhere on the board
PL_B35_L13_N: U200.H17 (IO_L13N_T2_MRCC_35); also elsewhere on the board
PL_B35_L13_P: U200.H16 (IO_L13P_T2_MRCC_35); also elsewhere on the board
PL_B35_L14_N: U200.H18 (IO_L14N_T2__AD4N_SRCC_35); also elsewhere on the board
PL_B35_L14_P: U200.J18 (IO_L14P_T2__AD4P_SRCC_35); also elsewhere on the board
PL_B35_L16_N: U200.G18 (IO_L16N_T2_35); also elsewhere on the board
PL_B35_L16_P: U200.G17 (IO_L16P_T2_35); also elsewhere on the board
PL_B35_L20_N: U200.J14 (IO_L20N_T3_AD6N_35); also elsewhere on the board
PL_B35_L20_P: U200.K14 (IO_L20P_T3_AD6P_35); also elsewhere on the board
PL_B35_L22_N: U200.L15 (IO_L22N_T3_AD7N_35); also elsewhere on the board
PL_B35_L22_P: U200.L14 (IO_L22P_T3_AD7P_35); also elsewhere on the board
PL_B35_L23_N: U200.M15 (IO_L23N_T3_35); also elsewhere on the board
PL_B35_L23_P: U200.M14 (IO_L23P_T3_35); also elsewhere on the board
PL_B35_L24_N: U200.J16 (IO_L24N_T3_AD15N_35); also elsewhere on the board
PL_CLK_125MHZ: U200.K17 (IO_L12P_T1_MRCC_35); also elsewhere on the board

Notes on the sheet:
Bank 35
BANK35
BANK34
[5] Zynq Programmable Logic (PL)
CLK from ETH PHY
Bank 34
