Dylanfg123/Zebra-X/ZeBra-X.kicad_pcb

## KiCad design ZeBra-X.kicad_pcb (continued)

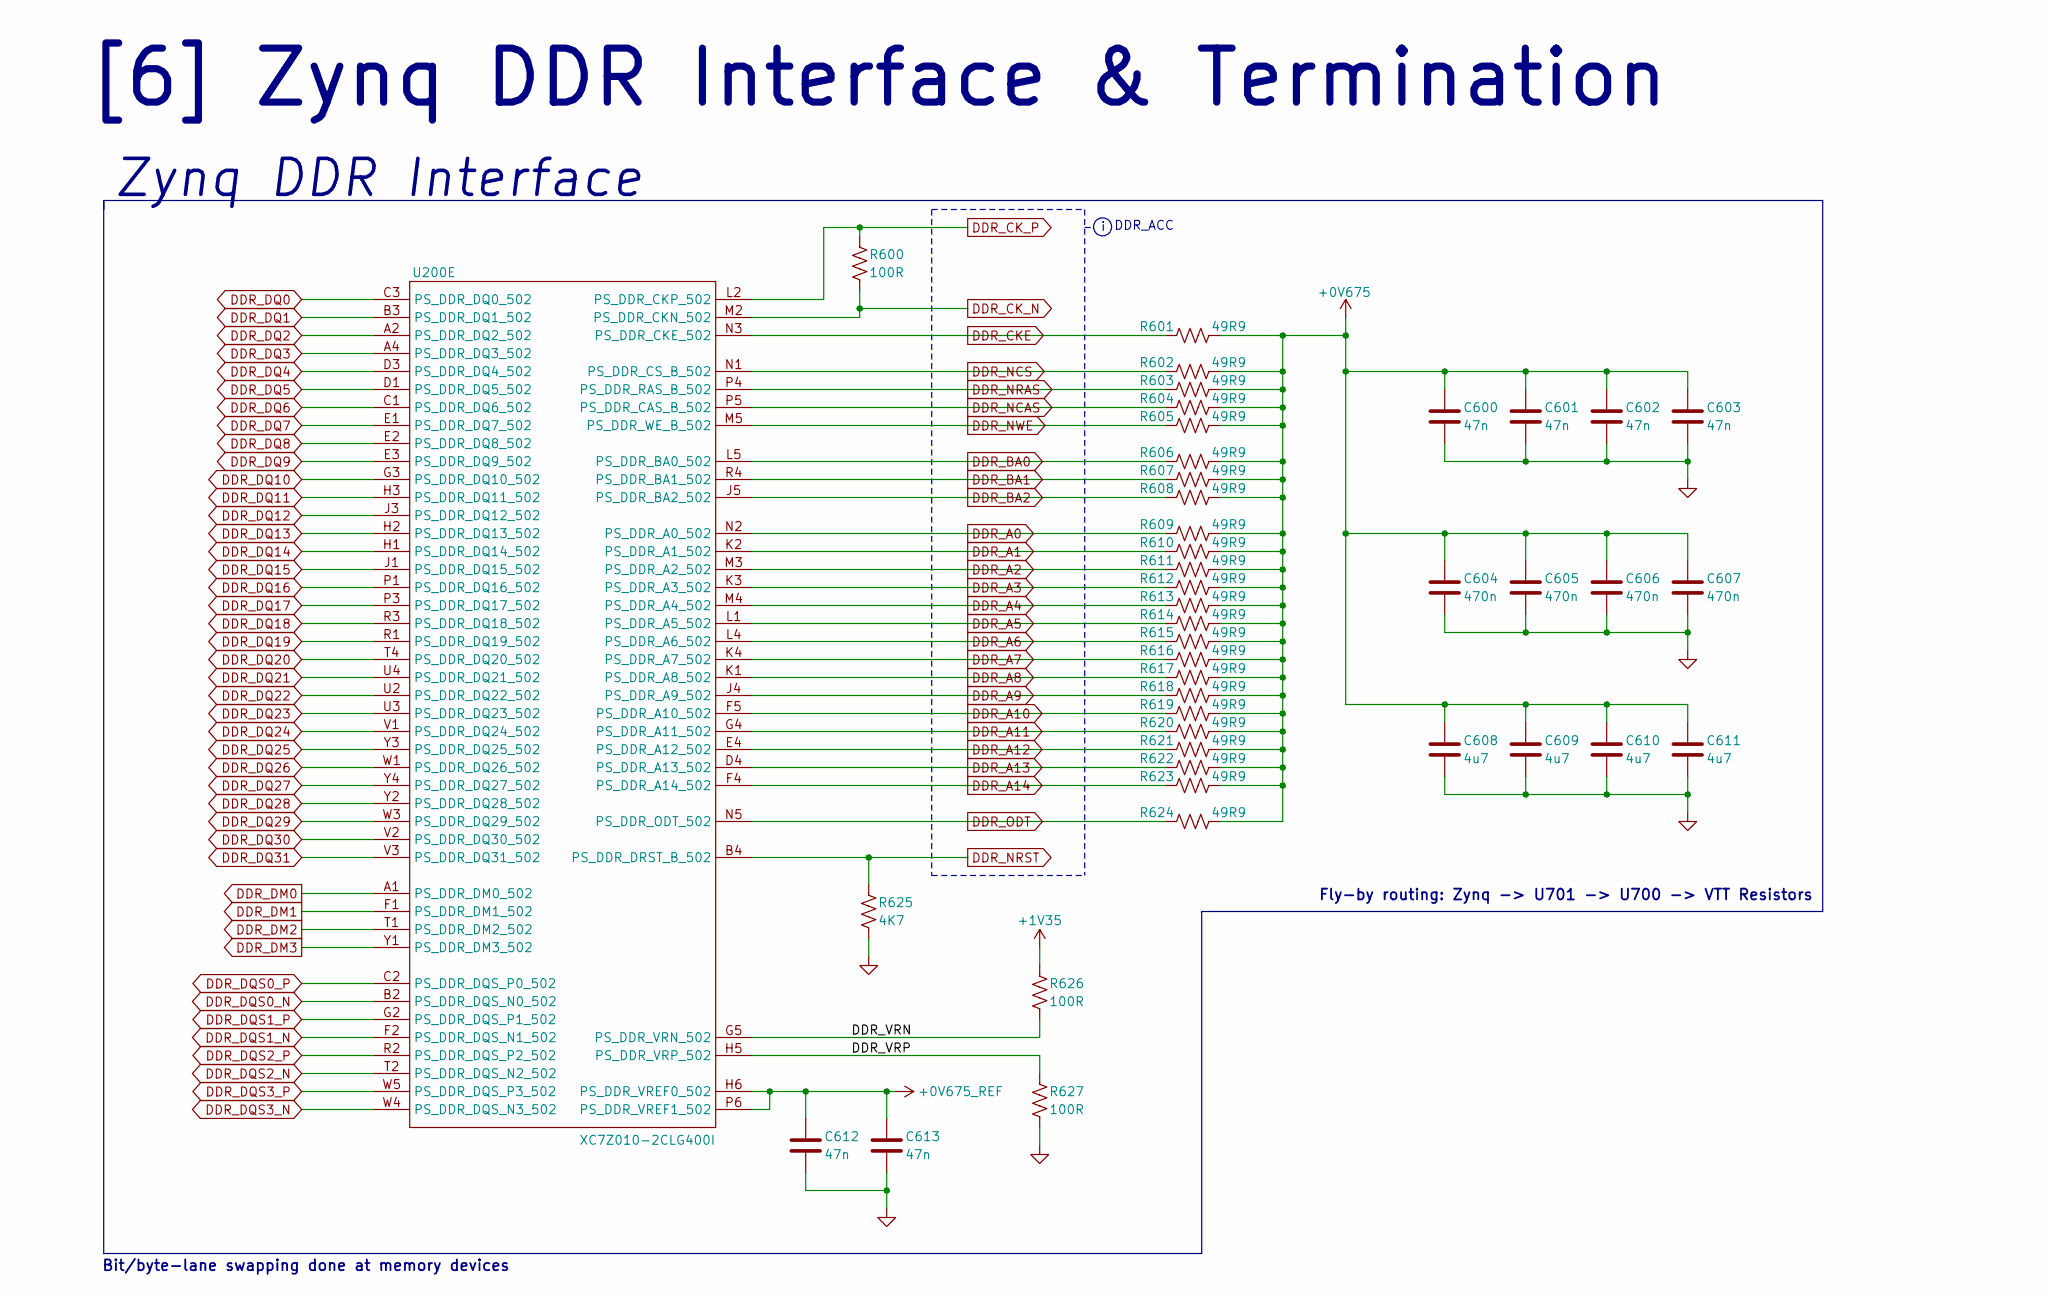
[picture p16: schematic Zynq_DDR_Interface_Termination.kicad_sch, Zynq DDR Interface & Termination]

Parts:
C600, C601, C602, C603, C612, C613: 47n; C_0201_0603Metric; Manufacturer PN GRT033R60J473KE01D; LCSC PN C126621
C604, C605, C606, C607: 470n; C_0201_0603Metric; Manufacturer PN GRM033R60J474KE90D; LCSC PN C85926
C608, C609, C610, C611: 4u7; C_0402_1005Metric; Manufacturer PN CL05A475MP5NRNC; LCSC PN C23733
R600, R626, R627: 100R; R_0201_0603Metric; Manufacturer PN RC0201FR-07100RL; LCSC PN C77623
R601, R602, R603, R604, R605, R606, R607, R608, R609, R610, R611, R612, R613, R614, R615, R616, R617, R618, R619, R620, R621, R622, R623, R624: 49R9; R_0201_0603Metric; Manufacturer PN RC0201FR-0749R9L; LCSC PN C155744
R625: 4K7; R_0402_1005Metric; Manufacturer PN RC0402FR-074K7L; LCSC PN C105871
U200: XC7Z010-2CLG400I; CLG400_XIL; Manufacturer PN XC7Z010-2CLG400I; LCSC PN C2840993

Connections:
+0V675: C600.1, C601.1, C602.1, C603.1, C604.1, C605.1, C606.1, C607.1, C608.1, C609.1, C610.1, C611.1, R601.1, R602.1, R603.1, R604.1, R605.1, R606.1, R607.1, R608.1, R609.1, R610.1, R611.1, R612.1, R613.1, R614.1, R615.1, R616.1, R617.1, R618.1, R619.1, R620.1, R621.1, R622.1, R623.1, R624.1; also elsewhere on the board
+0V675_REF: C612.1, C613.1, U200.H6 (PS_DDR_VREF0_502), U200.P6 (PS_DDR_VREF1_502); also elsewhere on the board
+1V35: R626.1; also elsewhere on the board
/[6] Zynq DDR Interface & Termination/DDR_VRN: R626.2, U200.G5 (PS_DDR_VRN_502)
/[6] Zynq DDR Interface & Termination/DDR_VRP: R627.1, U200.H5 (PS_DDR_VRP_502)
DDR_A0: R609.2, U200.N2 (PS_DDR_A0_502); also elsewhere on the board
DDR_A1: R610.2, U200.K2 (PS_DDR_A1_502); also elsewhere on the board
DDR_A2: R611.2, U200.M3 (PS_DDR_A2_502); also elsewhere on the board
DDR_A3: R612.2, U200.K3 (PS_DDR_A3_502); also elsewhere on the board
DDR_A4: R613.2, U200.M4 (PS_DDR_A4_502); also elsewhere on the board
DDR_A5: R614.2, U200.L1 (PS_DDR_A5_502); also elsewhere on the board
DDR_A6: R615.2, U200.L4 (PS_DDR_A6_502); also elsewhere on the board
DDR_A7: R616.2, U200.K4 (PS_DDR_A7_502); also elsewhere on the board
DDR_A8: R617.2, U200.K1 (PS_DDR_A8_502); also elsewhere on the board
DDR_A9: R618.2, U200.J4 (PS_DDR_A9_502); also elsewhere on the board
DDR_A10: R619.2, U200.F5 (PS_DDR_A10_502); also elsewhere on the board
DDR_A11: R620.2, U200.G4 (PS_DDR_A11_502); also elsewhere on the board
DDR_A12: R621.2, U200.E4 (PS_DDR_A12_502); also elsewhere on the board
DDR_A13: R622.2, U200.D4 (PS_DDR_A13_502); also elsewhere on the board
DDR_A14: R623.2, U200.F4 (PS_DDR_A14_502); also elsewhere on the board
DDR_BA0: R606.2, U200.L5 (PS_DDR_BA0_502); also elsewhere on the board
DDR_BA1: R607.2, U200.R4 (PS_DDR_BA1_502); also elsewhere on the board
DDR_BA2: R608.2, U200.J5 (PS_DDR_BA2_502); also elsewhere on the board
DDR_CKE: R601.2, U200.N3 (PS_DDR_CKE_502); also elsewhere on the board
DDR_CK_N: R600.2, U200.M2 (PS_DDR_CKN_502); also elsewhere on the board
DDR_CK_P: R600.1, U200.L2 (PS_DDR_CKP_502); also elsewhere on the board
DDR_DM0: U200.A1 (PS_DDR_DM0_502); also elsewhere on the board
DDR_DM1: U200.F1 (PS_DDR_DM1_502); also elsewhere on the board
DDR_DM2: U200.T1 (PS_DDR_DM2_502); also elsewhere on the board
DDR_DM3: U200.Y1 (PS_DDR_DM3_502); also elsewhere on the board
DDR_DQ0: U200.C3 (PS_DDR_DQ0_502); also elsewhere on the board
DDR_DQ1: U200.B3 (PS_DDR_DQ1_502); also elsewhere on the board
DDR_DQ2: U200.A2 (PS_DDR_DQ2_502); also elsewhere on the board
DDR_DQ3: U200.A4 (PS_DDR_DQ3_502); also elsewhere on the board
DDR_DQ4: U200.D3 (PS_DDR_DQ4_502); also elsewhere on the board
DDR_DQ5: U200.D1 (PS_DDR_DQ5_502); also elsewhere on the board
DDR_DQ6: U200.C1 (PS_DDR_DQ6_502); also elsewhere on the board
DDR_DQ7: U200.E1 (PS_DDR_DQ7_502); also elsewhere on the board
DDR_DQ8: U200.E2 (PS_DDR_DQ8_502); also elsewhere on the board
DDR_DQ9: U200.E3 (PS_DDR_DQ9_502); also elsewhere on the board
DDR_DQ10: U200.G3 (PS_DDR_DQ10_502); also elsewhere on the board
DDR_DQ11: U200.H3 (PS_DDR_DQ11_502); also elsewhere on the board
DDR_DQ12: U200.J3 (PS_DDR_DQ12_502); also elsewhere on the board
DDR_DQ13: U200.H2 (PS_DDR_DQ13_502); also elsewhere on the board
DDR_DQ14: U200.H1 (PS_DDR_DQ14_502); also elsewhere on the board
DDR_DQ15: U200.J1 (PS_DDR_DQ15_502); also elsewhere on the board
DDR_DQ16: U200.P1 (PS_DDR_DQ16_502); also elsewhere on the board
DDR_DQ17: U200.P3 (PS_DDR_DQ17_502); also elsewhere on the board
DDR_DQ18: U200.R3 (PS_DDR_DQ18_502); also elsewhere on the board
DDR_DQ19: U200.R1 (PS_DDR_DQ19_502); also elsewhere on the board
DDR_DQ20: U200.T4 (PS_DDR_DQ20_502); also elsewhere on the board
DDR_DQ21: U200.U4 (PS_DDR_DQ21_502); also elsewhere on the board
DDR_DQ22: U200.U2 (PS_DDR_DQ22_502); also elsewhere on the board
DDR_DQ23: U200.U3 (PS_DDR_DQ23_502); also elsewhere on the board
DDR_DQ24: U200.V1 (PS_DDR_DQ24_502); also elsewhere on the board
DDR_DQ25: U200.Y3 (PS_DDR_DQ25_502); also elsewhere on the board
DDR_DQ26: U200.W1 (PS_DDR_DQ26_502); also elsewhere on the board
DDR_DQ27: U200.Y4 (PS_DDR_DQ27_502); also elsewhere on the board
DDR_DQ28: U200.Y2 (PS_DDR_DQ28_502); also elsewhere on the board
DDR_DQ29: U200.W3 (PS_DDR_DQ29_502); also elsewhere on the board
DDR_DQ30: U200.V2 (PS_DDR_DQ30_502); also elsewhere on the board
DDR_DQ31: U200.V3 (PS_DDR_DQ31_502); also elsewhere on the board
DDR_DQS0_N: U200.B2 (PS_DDR_DQS_N0_502); also elsewhere on the board
DDR_DQS0_P: U200.C2 (PS_DDR_DQS_P0_502); also elsewhere on the board
DDR_DQS1_N: U200.F2 (PS_DDR_DQS_N1_502); also elsewhere on the board
DDR_DQS1_P: U200.G2 (PS_DDR_DQS_P1_502); also elsewhere on the board
DDR_DQS2_N: U200.T2 (PS_DDR_DQS_N2_502); also elsewhere on the board
DDR_DQS2_P: U200.R2 (PS_DDR_DQS_P2_502); also elsewhere on the board
DDR_DQS3_N: U200.W4 (PS_DDR_DQS_N3_502); also elsewhere on the board
DDR_DQS3_P: U200.W5 (PS_DDR_DQS_P3_502); also elsewhere on the board
DDR_NCAS: R604.2, U200.P5 (PS_DDR_CAS_B_502); also elsewhere on the board
DDR_NCS: R602.2, U200.N1 (PS_DDR_CS_B_502); also elsewhere on the board
DDR_NRAS: R603.2, U200.P4 (PS_DDR_RAS_B_502); also elsewhere on the board
DDR_NRST: R625.1, U200.B4 (PS_DDR_DRST_B_502); also elsewhere on the board
DDR_NWE: R605.2, U200.M5 (PS_DDR_WE_B_502); also elsewhere on the board
DDR_ODT: R624.2, U200.N5 (PS_DDR_ODT_502); also elsewhere on the board
GND: C600.2, C601.2, C602.2, C603.2, C604.2, C605.2, C606.2, C607.2, C608.2, C609.2, C610.2, C611.2, C612.2, C613.2, R625.2, R627.2; also elsewhere on the board

Notes on the sheet:
Bit/byte-lane swapping done at memory devices
Zynq DDR Interface
DDR_ACC
[6] Zynq DDR Interface & Termination
Fly-by routing: Zynq -> U701 -> U700 -> VTT Resistors

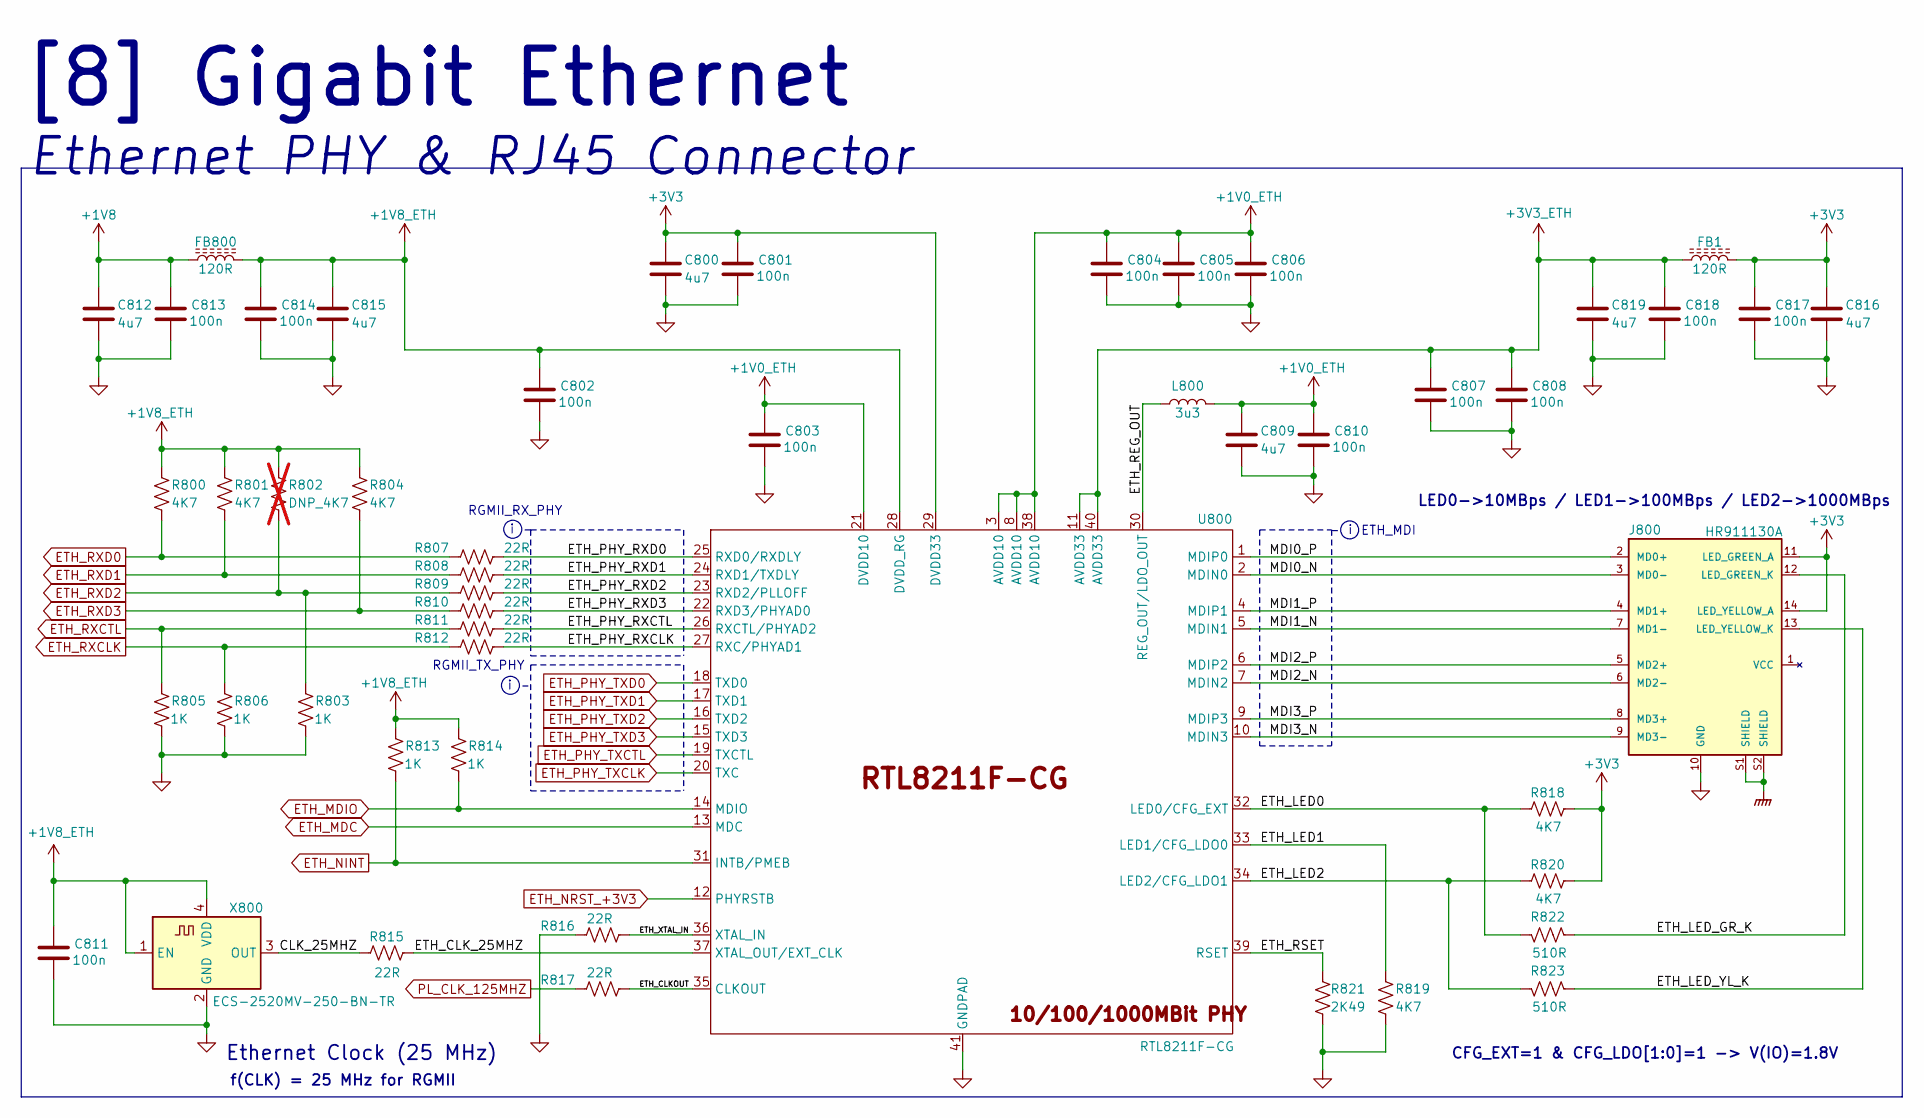
[picture p17: schematic Gigabit_Ethernet.kicad_sch, Gigabit Ethernet]

Parts:
C800, C809, C812, C815, C816, C819: 4u7; C_0402_1005Metric; Manufacturer PN CL05A475MP5NRNC; LCSC PN C23733
C801, C802, C803, C804, C805, C806, C807, C808, C810, C811, C813, C814, C817, C818: 100n; C_0402_1005Metric; Manufacturer PN CC0402KRX5R8BB104; LCSC PN C106256
FB1, FB800: 120R; L_0402_1005Metric; Manufacturer PN BLM15PX121SN1D; LCSC PN C88970
J800: HR911130A; HANRUN_HR911130A; Manufacturer PN HR911130A
L800: 3u3; L_0603_1608Metric; Manufacturer PN LQM18PN3R3MGHD
R800, R801, R804, R818, R819, R820: 4K7; R_0402_1005Metric; Manufacturer PN RC0402FR-074K7L; LCSC PN C105871
R802: DNP_4K7; R_0402_1005Metric; Manufacturer PN RC0402FR-074K7L; LCSC PN C105871; not fitted
R803, R805, R806, R813, R814: 1K; R_0402_1005Metric; Manufacturer PN RC0402FR-071KL; LCSC PN C106235
R807, R808, R809, R810, R811, R812, R815, R816, R817: 22R; R_0402_1005Metric; Manufacturer PN RC0402FR-0722RL; LCSC PN C114765
R821: 2K49; R_0402_1005Metric; Manufacturer PN RC0402FR-072K49L; LCSC PN C145071
R822, R823: 510R; R_0402_1005Metric; Manufacturer PN RC0402FR-07510RL; LCSC PN C276273
U800: RTL8211F-CG; QFN-40-1EP_5x5mm_P0.4mm_EP3.8x3.8mm; Manufacturer PN RTL8211F-CG; LCSC PN C187932
X800: ECS-2520MV-250-BN-TR; Oscillator_SMD_ECS_2520MV-xxx-xx-4Pin_2.5x2.0mm; Manufacturer PN ECS-2520MV-250-BN-TR

Connections:
+1V0_ETH: C803.1, C804.1, C805.1, C806.1, C809.1, C810.1, L800.2, U800.3 (AVDD10), U800.8 (AVDD10), U800.21 (DVDD10), U800.38 (AVDD10)
+1V8: C812.1, C813.1, FB800.1; also elsewhere on the board
+1V8_ETH: C802.1, C811.1, C814.1, C815.1, FB800.2, R800.1, R801.1, R802.1, R804.1, R813.2, R814.2, U800.28 (DVDD_RG), X800.1 (EN), X800.4 (VDD)
+3V3: C800.1, C801.1, C816.1, C817.1, FB1.2, J800.11 (LED_GREEN_A), J800.14 (LED_YELLOW_A), R818.2, R820.2, U800.29 (DVDD33); also elsewhere on the board
+3V3_ETH: C807.1, C808.1, C818.1, C819.1, FB1.1, U800.11 (AVDD33), U800.40 (AVDD33)
/[8] Gigabit Ethernet/CLK_25MHZ: R815.1, X800.3 (OUT)
/[8] Gigabit Ethernet/ETH_CLKOUT: R817.2, U800.35 (CLKOUT)
/[8] Gigabit Ethernet/ETH_CLK_25MHZ: R815.2, U800.37 (XTAL_OUT/EXT_CLK)
/[8] Gigabit Ethernet/ETH_LED0: R818.1, R822.2, U800.32 (LED0/CFG_EXT)
/[8] Gigabit Ethernet/ETH_LED1: R819.1, U800.33 (LED1/CFG_LDO0)
/[8] Gigabit Ethernet/ETH_LED2: R820.1, R823.2, U800.34 (LED2/CFG_LDO1)
/[8] Gigabit Ethernet/ETH_LED_GR_K: J800.12 (LED_GREEN_K), R822.1
/[8] Gigabit Ethernet/ETH_LED_YL_K: J800.13 (LED_YELLOW_K), R823.1
/[8] Gigabit Ethernet/ETH_PHY_RXCLK: R812.2, U800.27 (RXC/PHYAD1)
/[8] Gigabit Ethernet/ETH_PHY_RXCTL: R811.2, U800.26 (RXCTL/PHYAD2)
/[8] Gigabit Ethernet/ETH_PHY_RXD0: R807.2, U800.25 (RXD0/RXDLY)
/[8] Gigabit Ethernet/ETH_PHY_RXD1: R808.2, U800.24 (RXD1/TXDLY)
/[8] Gigabit Ethernet/ETH_PHY_RXD2: R809.2, U800.23 (RXD2/PLLOFF)
/[8] Gigabit Ethernet/ETH_PHY_RXD3: R810.2, U800.22 (RXD3/PHYAD0)
/[8] Gigabit Ethernet/ETH_REG_OUT: L800.1, U800.30 (REG_OUT/LDO_OUT)
/[8] Gigabit Ethernet/ETH_RSET: R821.1, U800.39 (RSET)
/[8] Gigabit Ethernet/ETH_XTAL_IN: R816.2, U800.36 (XTAL_IN)
/[8] Gigabit Ethernet/MDI0_N: J800.3 (MD0-), U800.2 (MDIN0)
/[8] Gigabit Ethernet/MDI0_P: J800.2 (MD0+), U800.1 (MDIP0)
/[8] Gigabit Ethernet/MDI1_N: J800.7 (MD1-), U800.5 (MDIN1)
/[8] Gigabit Ethernet/MDI1_P: J800.4 (MD1+), U800.4 (MDIP1)
/[8] Gigabit Ethernet/MDI2_N: J800.6 (MD2-), U800.7 (MDIN2)
/[8] Gigabit Ethernet/MDI2_P: J800.5 (MD2+), U800.6 (MDIP2)
/[8] Gigabit Ethernet/MDI3_N: J800.9 (MD3-), U800.10 (MDIN3)
/[8] Gigabit Ethernet/MDI3_P: J800.8 (MD3+), U800.9 (MDIP3)
ETH_MDC: U800.13 (MDC); also elsewhere on the board
ETH_MDIO: R814.1, U800.14 (MDIO); also elsewhere on the board
ETH_NINT: R813.1, U800.31 (INTB/PMEB); also elsewhere on the board
ETH_NRST_+3V3: U800.12 (PHYRSTB); also elsewhere on the board
ETH_PHY_TXCLK: U800.20 (TXC); also elsewhere on the board
ETH_PHY_TXCTL: U800.19 (TXCTL); also elsewhere on the board
ETH_PHY_TXD0: U800.18 (TXD0); also elsewhere on the board
ETH_PHY_TXD1: U800.17 (TXD1); also elsewhere on the board
ETH_PHY_TXD2: U800.16 (TXD2); also elsewhere on the board
ETH_PHY_TXD3: U800.15 (TXD3); also elsewhere on the board
ETH_RXCLK: R806.2, R812.1; also elsewhere on the board
ETH_RXCTL: R805.2, R811.1; also elsewhere on the board
ETH_RXD0: R800.2, R807.1; also elsewhere on the board
ETH_RXD1: R801.2, R808.1; also elsewhere on the board
ETH_RXD2: R802.2, R803.2, R809.1; also elsewhere on the board
ETH_RXD3: R804.2, R810.1; also elsewhere on the board
GND: C800.2, C801.2, C802.2, C803.2, C804.2, C805.2, C806.2, C807.2, C808.2, C809.2, C810.2, C811.2, C812.2, C813.2, C814.2, C815.2, C816.2, C817.2, C818.2, C819.2, J800.10 (GND), R803.1, R805.1, R806.1, R816.1, R819.2, R821.2, U800.41 (GNDPAD), X800.2 (GND); also elsewhere on the board
GNDPWR: J800.S1 (SHIELD), J800.S2 (SHIELD); also elsewhere on the board
PL_CLK_125MHZ: R817.1; also elsewhere on the board

Notes on the sheet:
RGMII_TX_PHY
Ethernet PHY & RJ45 Connector
[8] Gigabit Ethernet
RGMII_RX_PHY
Ethernet Clock (25 MHz)
LED0->10MBps / LED1->100MBps / LED2->1000MBps
f(CLK) = 25 MHz for RGMII
CFG_EXT=1 & CFG_LDO[1:0]=1 -> V(IO)=1.8V
ETH_MDI

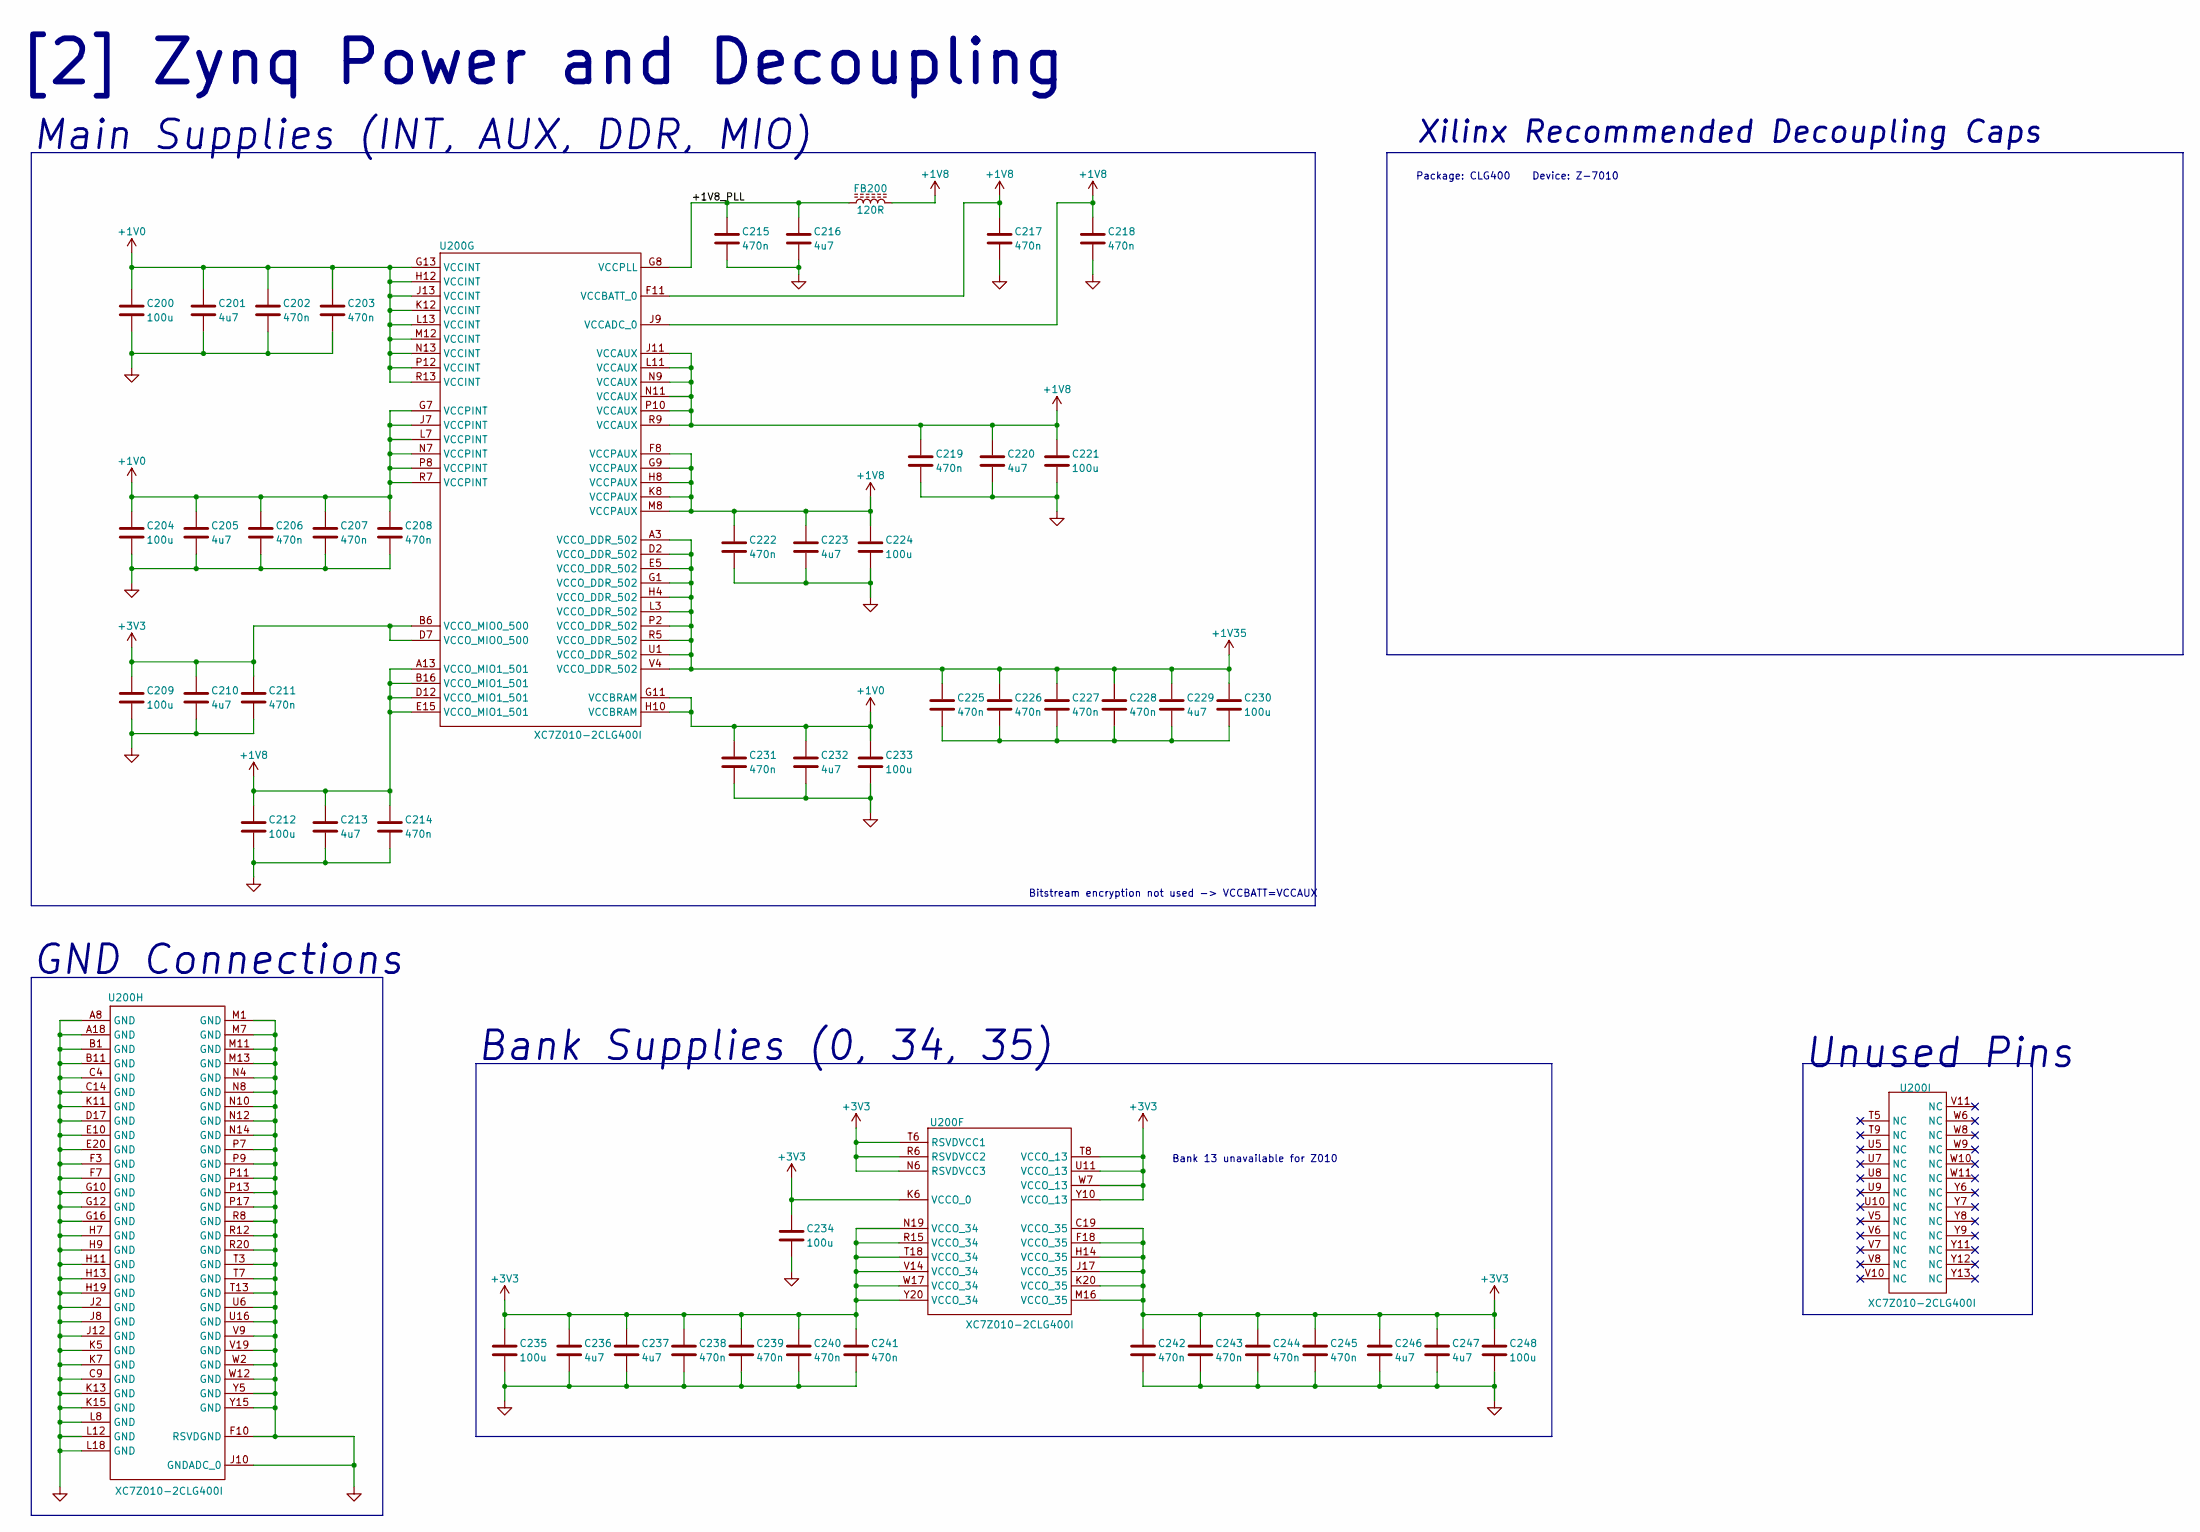
[picture p18: schematic Zynq_Power.kicad_sch, Zynq Power]

Parts:
C200, C204, C209, C212, C221, C224, C230, C233, C234, C235, C248: 100u; C_1210_3225Metric; Manufacturer PN CL32A107MQVNNNE; LCSC PN C49066
C201, C205, C210, C213, C216, C220, C223, C229, C232, C236, C237, C246, C247: 4u7; C_0402_1005Metric; Manufacturer PN CL05A475MP5NRNC; LCSC PN C23733
C202, C203, C206, C207, C208, C211, C214, C215, C217, C218, C219, C222, C225, C226, C227, C228, C231, C238, C239, C240, C241, C242, C243, C244, C245: 470n; C_0201_0603Metric; Manufacturer PN GRM033R60J474KE90D; LCSC PN C85926
FB200: 120R; L_0402_1005Metric; Manufacturer PN BLM15PX121SN1D; LCSC PN C88970
U200: XC7Z010-2CLG400I; CLG400_XIL; Manufacturer PN XC7Z010-2CLG400I; LCSC PN C2840993

Connections:
+1V0: C200.1, C201.1, C202.1, C203.1, C204.1, C205.1, C206.1, C207.1, C208.1, C231.1, C232.1, C233.1, U200.G7 (VCCPINT), U200.G11 (VCCBRAM), U200.G13 (VCCINT), U200.H10 (VCCBRAM), U200.H12 (VCCINT), U200.J7 (VCCPINT), U200.J13 (VCCINT), U200.K12 (VCCINT), U200.L7 (VCCPINT), U200.L13 (VCCINT), U200.M12 (VCCINT), U200.N7 (VCCPINT), U200.N13 (VCCINT), U200.P8 (VCCPINT), U200.P12 (VCCINT), U200.R7 (VCCPINT), U200.R13 (VCCINT); also elsewhere on the board
+1V8: C212.1, C213.1, C214.1, C217.1, C218.1, C219.1, C220.1, C221.1, C222.1, C223.1, C224.1, FB200.2, U200.A13 (VCCO_MIO1_501), U200.B16 (VCCO_MIO1_501), U200.D12 (VCCO_MIO1_501), U200.E15 (VCCO_MIO1_501), U200.F8 (VCCPAUX), U200.F11 (VCCBATT_0), U200.G9 (VCCPAUX), U200.H8 (VCCPAUX), U200.J9 (VCCADC_0), U200.J11 (VCCAUX), U200.K8 (VCCPAUX), U200.L11 (VCCAUX), U200.M8 (VCCPAUX), U200.N9 (VCCAUX), U200.N11 (VCCAUX), U200.P10 (VCCAUX), U200.R9 (VCCAUX); also elsewhere on the board
+1V35: C225.1, C226.1, C227.1, C228.1, C229.1, C230.1, U200.A3 (VCCO_DDR_502), U200.D2 (VCCO_DDR_502), U200.E5 (VCCO_DDR_502), U200.G1 (VCCO_DDR_502), U200.H4 (VCCO_DDR_502), U200.L3 (VCCO_DDR_502), U200.P2 (VCCO_DDR_502), U200.R5 (VCCO_DDR_502), U200.U1 (VCCO_DDR_502), U200.V4 (VCCO_DDR_502); also elsewhere on the board
+3V3: C209.1, C210.1, C211.1, C234.1, C235.1, C236.1, C237.1, C238.1, C239.1, C240.1, C241.1, C242.1, C243.1, C244.1, C245.1, C246.1, C247.1, C248.1, U200.B6 (VCCO_MIO0_500), U200.C19 (VCCO_35), U200.D7 (VCCO_MIO0_500), U200.F18 (VCCO_35), U200.H14 (VCCO_35), U200.J17 (VCCO_35), U200.K6 (VCCO_0), U200.K20 (VCCO_35), U200.M16 (VCCO_35), U200.N6 (RSVDVCC3), U200.N19 (VCCO_34), U200.R6 (RSVDVCC2), U200.R15 (VCCO_34), U200.T6 (RSVDVCC1), U200.T8 (VCCO_13), U200.T18 (VCCO_34), U200.U11 (VCCO_13), U200.V14 (VCCO_34), U200.W7 (VCCO_13), U200.W17 (VCCO_34), U200.Y10 (VCCO_13), U200.Y20 (VCCO_34); also elsewhere on the board
/[2] Zynq Power/+1V8_PLL: C215.1, C216.1, FB200.1, U200.G8 (VCCPLL)
GND: C200.2, C201.2, C202.2, C203.2, C204.2, C205.2, C206.2, C207.2, C208.2, C209.2, C210.2, C211.2, C212.2, C213.2, C214.2, C215.2, C216.2, C217.2, C218.2, C219.2, C220.2, C221.2, C222.2, C223.2, C224.2, C231.2, C232.2, C233.2, C234.2, C235.2, C236.2, C237.2, C238.2, C239.2, C240.2, C241.2, C242.2, C243.2, C244.2, C245.2, C246.2, C247.2, C248.2, U200.A8 (GND), U200.A18 (GND), U200.B1 (GND), U200.B11 (GND), U200.C4 (GND), U200.C9 (GND), U200.C14 (GND), U200.D17 (GND), U200.E10 (GND), U200.E20 (GND), U200.F3 (GND), U200.F7 (GND), U200.F10 (RSVDGND), U200.G10 (GND), U200.G12 (GND), U200.G16 (GND), U200.H7 (GND), U200.H9 (GND), U200.H11 (GND), U200.H13 (GND), U200.H19 (GND), U200.J2 (GND), U200.J8 (GND), U200.J10 (GNDADC_0), U200.J12 (GND), U200.K5 (GND), U200.K7 (GND), U200.K11 (GND), U200.K13 (GND), U200.K15 (GND), U200.L8 (GND), U200.L12 (GND), U200.L18 (GND), U200.M1 (GND), U200.M7 (GND), U200.M11 (GND), U200.M13 (GND), U200.N4 (GND), U200.N8 (GND), U200.N10 (GND), U200.N12 (GND), U200.N14 (GND), U200.P7 (GND), U200.P9 (GND), U200.P11 (GND), U200.P13 (GND), U200.P17 (GND), U200.R8 (GND), U200.R12 (GND), U200.R20 (GND), U200.T3 (GND), U200.T7 (GND), U200.T13 (GND), U200.U6 (GND), U200.U16 (GND), U200.V9 (GND), U200.V19 (GND), U200.W2 (GND), U200.W12 (GND), U200.Y5 (GND), U200.Y15 (GND); also elsewhere on the board
unnamed: C225.2, C226.2, C227.2, C228.2, C229.2, C230.2

Notes on the sheet:
Main Supplies (INT, AUX, DDR, MIO)
Bank Supplies (0, 34, 35)
Unused Pins
Xilinx Recommended Decoupling Caps
[2] Zynq Power and Decoupling
Package: CLG400 Device: Z-7010
Bank 13 unavailable for Z010
Bitstream encryption not used -> VCCBATT=VCCAUX
GND Connections

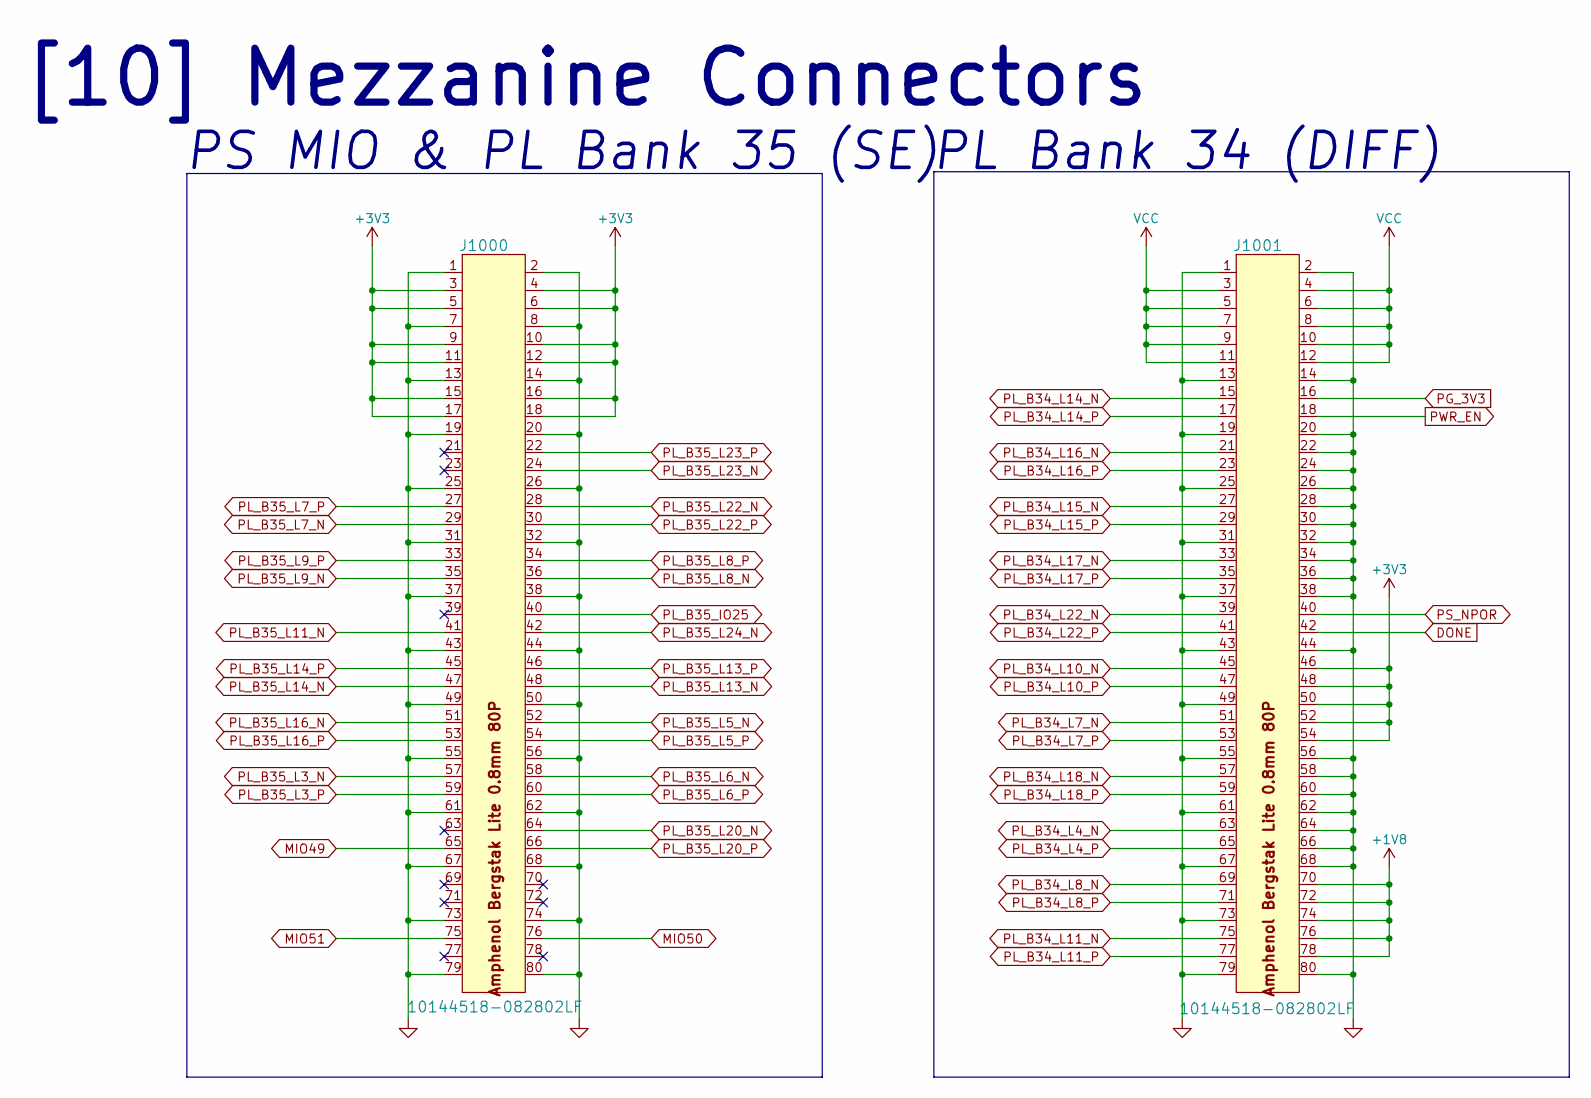
[picture p19: schematic Mezzanine_conn.kicad_sch, Expansion (Mezzanine)]

Parts:
J1000, J1001: 10144518-082802LF; CONN_10144518_AMP; Manufacturer PN 10144518-082802LF

Connections:
+1V8: J1001.70, J1001.72, J1001.74, J1001.76, J1001.78; also elsewhere on the board
+3V3: J1000.3, J1000.4, J1000.5, J1000.6, J1000.9, J1000.10, J1000.11, J1000.12, J1000.15, J1000.16, J1000.17, J1000.18, J1001.46, J1001.48, J1001.50, J1001.52, J1001.54; also elsewhere on the board
DONE: J1001.42; also elsewhere on the board
GND: J1000.1, J1000.2, J1000.7, J1000.8, J1000.13, J1000.14, J1000.19, J1000.20, J1000.25, J1000.26, J1000.31, J1000.32, J1000.37, J1000.38, J1000.43, J1000.44, J1000.49, J1000.50, J1000.55, J1000.56, J1000.61, J1000.62, J1000.67, J1000.68, J1000.73, J1000.74, J1000.79, J1000.80, J1001.1, J1001.2, J1001.13, J1001.14, J1001.19, J1001.20, J1001.22, J1001.24, J1001.25, J1001.26, J1001.28, J1001.30, J1001.31, J1001.32, J1001.34, J1001.36, J1001.37, J1001.38, J1001.43, J1001.44, J1001.49, J1001.55, J1001.56, J1001.58, J1001.60, J1001.61, J1001.62, J1001.64, J1001.66, J1001.67, J1001.68, J1001.73, J1001.79, J1001.80; also elsewhere on the board
MIO49: J1000.65; also elsewhere on the board
MIO50: J1000.76; also elsewhere on the board
MIO51: J1000.75; also elsewhere on the board
PG_3V3: J1001.16; also elsewhere on the board
PL_B34_L4_N: J1001.63; also elsewhere on the board
PL_B34_L4_P: J1001.65; also elsewhere on the board
PL_B34_L7_N: J1001.51; also elsewhere on the board
PL_B34_L7_P: J1001.53; also elsewhere on the board
PL_B34_L8_N: J1001.69; also elsewhere on the board
PL_B34_L8_P: J1001.71; also elsewhere on the board
PL_B34_L10_N: J1001.45; also elsewhere on the board
PL_B34_L10_P: J1001.47; also elsewhere on the board
PL_B34_L11_N: J1001.75; also elsewhere on the board
PL_B34_L11_P: J1001.77; also elsewhere on the board
PL_B34_L14_N: J1001.15; also elsewhere on the board
PL_B34_L14_P: J1001.17; also elsewhere on the board
PL_B34_L15_N: J1001.27; also elsewhere on the board
PL_B34_L15_P: J1001.29; also elsewhere on the board
PL_B34_L16_N: J1001.21; also elsewhere on the board
PL_B34_L16_P: J1001.23; also elsewhere on the board
PL_B34_L17_N: J1001.33; also elsewhere on the board
PL_B34_L17_P: J1001.35; also elsewhere on the board
PL_B34_L18_N: J1001.57; also elsewhere on the board
PL_B34_L18_P: J1001.59; also elsewhere on the board
PL_B34_L22_N: J1001.39; also elsewhere on the board
PL_B34_L22_P: J1001.41; also elsewhere on the board
PL_B35_IO25: J1000.40; also elsewhere on the board
PL_B35_L3_N: J1000.57; also elsewhere on the board
PL_B35_L3_P: J1000.59; also elsewhere on the board
PL_B35_L5_N: J1000.52; also elsewhere on the board
PL_B35_L5_P: J1000.54; also elsewhere on the board
PL_B35_L6_N: J1000.58; also elsewhere on the board
PL_B35_L6_P: J1000.60; also elsewhere on the board
PL_B35_L7_N: J1000.29; also elsewhere on the board
PL_B35_L7_P: J1000.27; also elsewhere on the board
PL_B35_L8_N: J1000.36; also elsewhere on the board
PL_B35_L8_P: J1000.34; also elsewhere on the board
PL_B35_L9_N: J1000.35; also elsewhere on the board
PL_B35_L9_P: J1000.33; also elsewhere on the board
PL_B35_L11_N: J1000.41; also elsewhere on the board
PL_B35_L13_N: J1000.48; also elsewhere on the board
PL_B35_L13_P: J1000.46; also elsewhere on the board
PL_B35_L14_N: J1000.47; also elsewhere on the board
PL_B35_L14_P: J1000.45; also elsewhere on the board
PL_B35_L16_N: J1000.51; also elsewhere on the board
PL_B35_L16_P: J1000.53; also elsewhere on the board
PL_B35_L20_N: J1000.64; also elsewhere on the board
PL_B35_L20_P: J1000.66; also elsewhere on the board
PL_B35_L22_N: J1000.28; also elsewhere on the board
PL_B35_L22_P: J1000.30; also elsewhere on the board
PL_B35_L23_N: J1000.24; also elsewhere on the board
PL_B35_L23_P: J1000.22; also elsewhere on the board
PL_B35_L24_N: J1000.42; also elsewhere on the board
PS_NPOR: J1001.40; also elsewhere on the board
PWR_EN: J1001.18; also elsewhere on the board
VCC: J1001.3, J1001.4, J1001.5, J1001.6, J1001.7, J1001.8, J1001.9, J1001.10, J1001.11, J1001.12; also elsewhere on the board

Notes on the sheet:
PL Bank 34 (DIFF)
[10] Mezzanine Connectors
PS MIO & PL Bank 35 (SE)
