Dylanfg123/Zebra-X/ZeBra-X.kicad_pcb

## KiCad design ZeBra-X.kicad_pcb (continued)

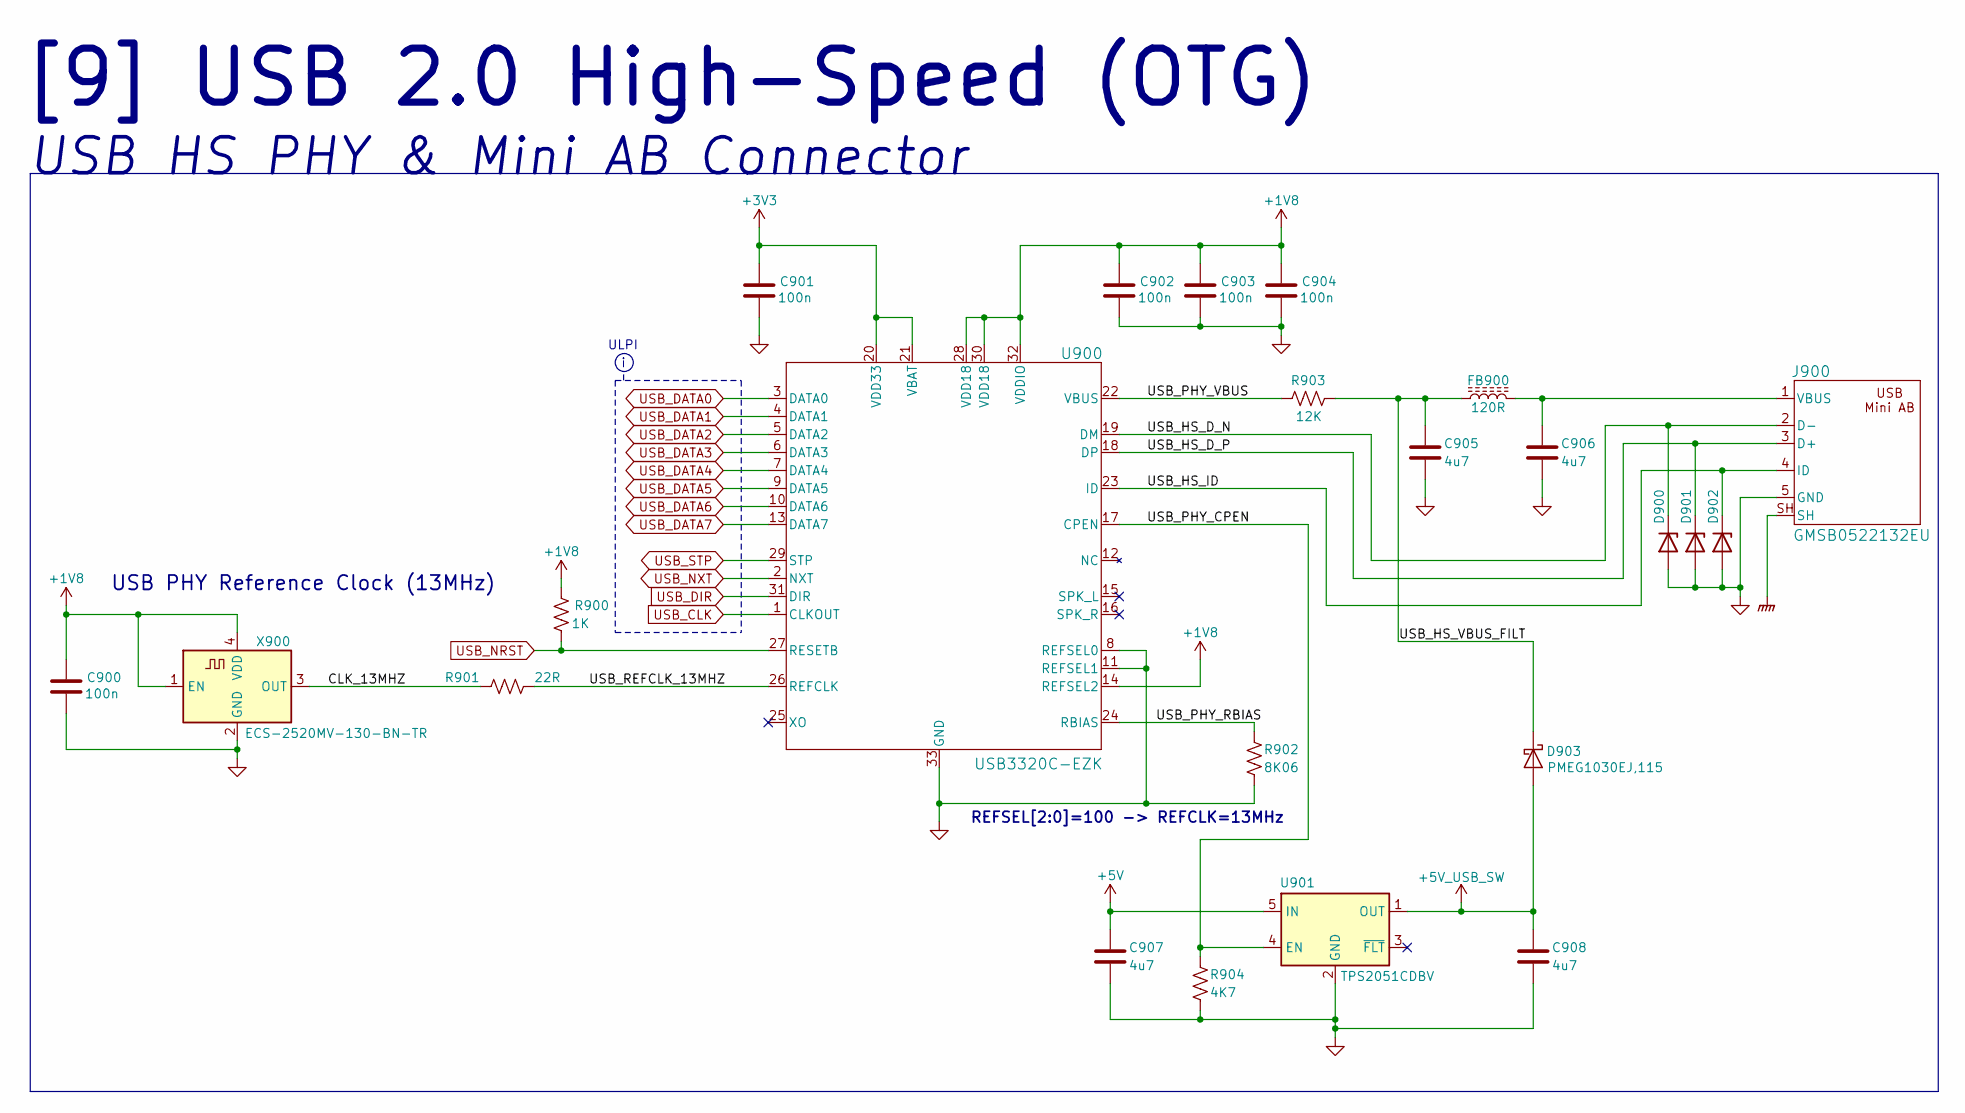
[picture p20: schematic USB_2.0_HS.kicad_sch, USB 2.0 HS]

Parts:
C900, C901, C902, C903, C904: 100n; C_0402_1005Metric; Manufacturer PN CC0402KRX5R8BB104; LCSC PN C106256
C905, C906, C907, C908: 4u7; C_0402_1005Metric; Manufacturer PN CL05A475MP5NRNC; LCSC PN C23733
D900, D901, D902: CG0402MLU-3.3G; D_0402_1005Metric; Manufacturer PN CG0402MLU-3.3G; LCSC PN C2655393
D903: PMEG1030EJ,115; D_SOD-323F; Manufacturer PN PMEG1030EJ,115; LCSC PN C133633
FB900: 120R; L_0402_1005Metric; Manufacturer PN BLM15PX121SN1D; LCSC PN C88970
J900: GMSB0522132EU; Manufacturer PN GMSB0522132EU
R900: 1K; R_0402_1005Metric; Manufacturer PN RC0402FR-071KL; LCSC PN C106235
R901: 22R; R_0402_1005Metric; Manufacturer PN RC0402FR-0722RL; LCSC PN C114765
R902: 8K06; R_0402_1005Metric; Manufacturer PN RC0402FR-078K06L; LCSC PN C276278
R903: 12K; R_0402_1005Metric; Manufacturer PN RTT021202FTH; LCSC PN C102781
R904: 4K7; R_0402_1005Metric; Manufacturer PN RC0402FR-074K7L; LCSC PN C105871
U900: USB3320C-EZK; QFN32_5X5MC_MCH; Manufacturer PN USB3320C-EZK; LCSC PN C52447
U901: TPS2051CDBV; SOT-23-5; Manufacturer PN TPS2051CDBVR; LCSC PN C129581
X900: ECS-2520MV-130-BN-TR; Oscillator_SMD_ECS_2520MV-xxx-xx-4Pin_2.5x2.0mm; Manufacturer PN ECS-2520MV-130-BN-TR

Connections:
+1V8: C900.1, C902.1, C903.1, C904.1, R900.2, U900.14 (REFSEL2), U900.28 (VDD18), U900.30 (VDD18), U900.32 (VDDIO), X900.1 (EN), X900.4 (VDD); also elsewhere on the board
+3V3: C901.1, U900.20 (VDD33), U900.21 (VBAT); also elsewhere on the board
+5V: C907.1, U901.5 (IN); also elsewhere on the board
+5V_USB_SW: C908.1, D903.2 (A), U901.1 (OUT)
/[9] USB 2.0 HS/CLK_13MHZ: R901.1, X900.3 (OUT)
/[9] USB 2.0 HS/USB_HS_D_N: D900.1 (K), J900.2 (D-), U900.19 (DM)
/[9] USB 2.0 HS/USB_HS_D_P: D901.1 (K), J900.3 (D+), U900.18 (DP)
/[9] USB 2.0 HS/USB_HS_ID: D902.1 (K), J900.4 (ID), U900.23 (ID)
/[9] USB 2.0 HS/USB_HS_VBUS_FILT: C905.1, D903.1 (K), FB900.1, R903.2
/[9] USB 2.0 HS/USB_PHY_CPEN: R904.1, U900.17 (CPEN), U901.4 (EN)
/[9] USB 2.0 HS/USB_PHY_RBIAS: R902.1, U900.24 (RBIAS)
/[9] USB 2.0 HS/USB_PHY_VBUS: R903.1, U900.22 (VBUS)
/[9] USB 2.0 HS/USB_REFCLK_13MHZ: R901.2, U900.26 (REFCLK)
GND: C900.2, C901.2, C902.2, C903.2, C904.2, C905.2, C906.2, C907.2, C908.2, D900.2 (A), D901.2 (A), D902.2 (A), J900.5 (GND), R902.2, R904.2, U900.8 (REFSEL0), U900.11 (REFSEL1), U900.33 (GND), U901.2 (GND), X900.2 (GND); also elsewhere on the board
GNDPWR: J900.SH; also elsewhere on the board
unnamed: C906.1, FB900.2, J900.1 (VBUS)
USB_CLK: U900.1 (CLKOUT); also elsewhere on the board
USB_DATA0: U900.3 (DATA0); also elsewhere on the board
USB_DATA1: U900.4 (DATA1); also elsewhere on the board
USB_DATA2: U900.5 (DATA2); also elsewhere on the board
USB_DATA3: U900.6 (DATA3); also elsewhere on the board
USB_DATA4: U900.7 (DATA4); also elsewhere on the board
USB_DATA5: U900.9 (DATA5); also elsewhere on the board
USB_DATA6: U900.10 (DATA6); also elsewhere on the board
USB_DATA7: U900.13 (DATA7); also elsewhere on the board
USB_DIR: U900.31 (DIR); also elsewhere on the board
USB_NRST: R900.1, U900.27 (RESETB); also elsewhere on the board
USB_NXT: U900.2 (NXT); also elsewhere on the board
USB_STP: U900.29 (STP); also elsewhere on the board

Notes on the sheet:
USB PHY Reference Clock (13MHz)
ULPI
[9] USB 2.0 High-Speed (OTG)
REFSEL[2:0]=100 -> REFCLK=13MHz
USB HS PHY & Mini AB Connector

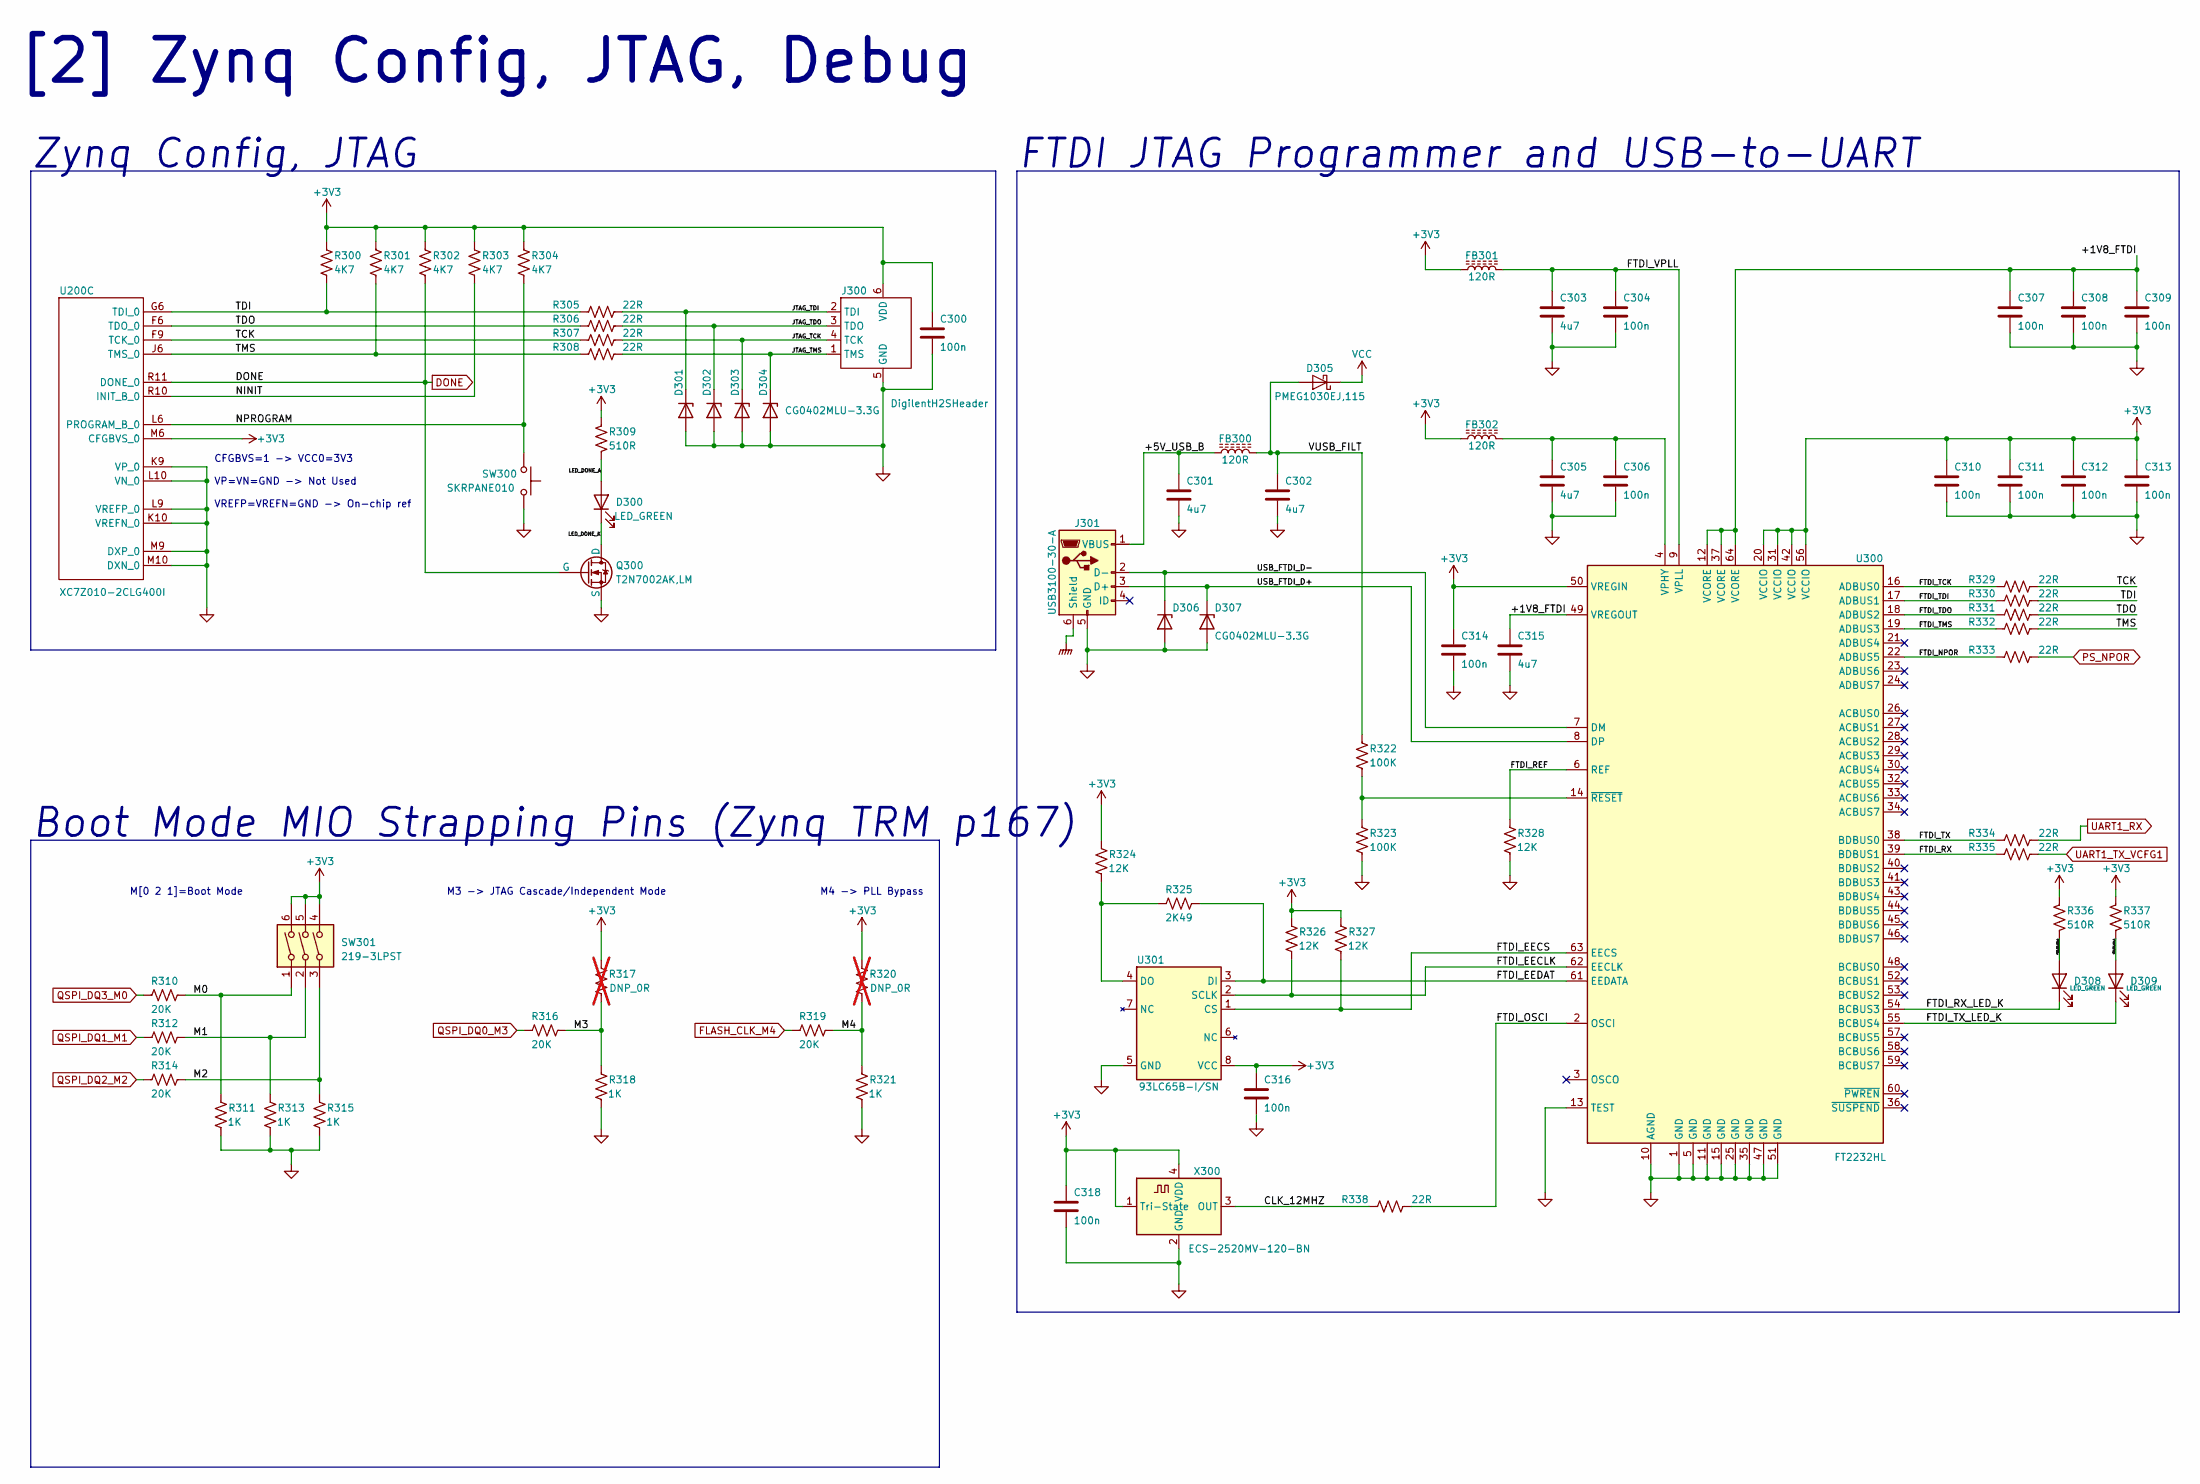
[picture p21: schematic Config_JTAG_Debug.kicad_sch, Zynq Config]

Parts:
C300, C304, C306, C307, C308, C309, C310, C311, C312, C313, C314, C316, C318: 100n; C_0402_1005Metric; Manufacturer PN CC0402KRX5R8BB104; LCSC PN C106256
C301, C302, C303, C305, C315: 4u7; C_0402_1005Metric; Manufacturer PN CL05A475MP5NRNC; LCSC PN C23733
D300, D308, D309: LED_GREEN; LED_0402_1005Metric; Manufacturer PN SZYY0402YG; LCSC PN C434449
D301, D302, D303, D304, D306, D307: CG0402MLU-3.3G; D_0402_1005Metric; Manufacturer PN CG0402MLU-3.3G; LCSC PN C2655393
D305: PMEG1030EJ,115; D_SOD-323F; Manufacturer PN PMEG1030EJ,115; LCSC PN C133633
FB300, FB301, FB302: 120R; L_0402_1005Metric; Manufacturer PN BLM15PX121SN1D; LCSC PN C88970
J300: DigilentH2SHeader; PinHeader_1x06_P2.54mm_Vertical
J301: USB3100-30-A; CONN_USB3100-30-A_GCT; Manufacturer PN USB3100-30-A
Q300: T2N7002AK,LM; SOT23_TOS; Manufacturer PN T2N7002AK,LM; LCSC PN C516175
R300, R301, R302, R303, R304: 4K7; R_0402_1005Metric; Manufacturer PN RC0402FR-074K7L; LCSC PN C105871
R305, R306, R307, R308, R329, R330, R331, R332, R333, R334, R335, R338: 22R; R_0402_1005Metric; Manufacturer PN RC0402FR-0722RL; LCSC PN C114765
R309, R336, R337: 510R; R_0402_1005Metric; Manufacturer PN RC0402FR-07510RL; LCSC PN C276273
R310, R312, R314, R316, R319: 20K; R_0402_1005Metric; Manufacturer PN RC0402FR-0720KL; LCSC PN C93942
R311, R313, R315, R318, R321: 1K; R_0402_1005Metric; Manufacturer PN RC0402FR-071KL; LCSC PN C106235
R317, R320: DNP_0R; R_0402_1005Metric; not fitted
R322, R323: 100K; R_0402_1005Metric; Manufacturer PN RC0402FR-07100KL; LCSC PN C60491
R324, R326, R327, R328: 12K; R_0402_1005Metric; Manufacturer PN RTT021202FTH; LCSC PN C102781
R325: 2K49; R_0402_1005Metric; Manufacturer PN RC0402FR-072K49L; LCSC PN C145071
SW300: SKRPANE010; SW_Push_1P1T_NO_Vertical_Wuerth_434133025816; Manufacturer PN SKRPANE010; LCSC PN C470426
SW301: 219-3LPST; SW_DIP_SPSTx03_Slide_6.7x9.18mm_W8.61mm_P2.54mm_LowProfile; Manufacturer PN 219-3LPST
U200: XC7Z010-2CLG400I; CLG400_XIL; Manufacturer PN XC7Z010-2CLG400I; LCSC PN C2840993
U300: FT2232HL; LQFP-64_10x10mm_P0.5mm; Manufacturer PN FT2232HL-REEL; LCSC PN C27882
U301: 93LC65B-I/SN; SOIC-8_3.9x4.9mm_P1.27mm; Manufacturer PN 93LC56B-I/SN; LCSC PN C183620
X300: ECS-2520MV-120-BN; Oscillator_SMD_ECS_2520MV-xxx-xx-4Pin_2.5x2.0mm; Manufacturer PN ECS-2520MV-120-BN-TR; LCSC PN C405460

Connections:
+3V3: C300.1, C310.1, C311.1, C312.1, C313.1, C314.1, C316.1, C318.1, FB301.1, FB302.1, J300.6 (VDD), R300.1, R301.1, R302.1, R303.1, R304.1, R309.2, R317.2, R320.2, R324.2, R326.2, R327.2, R336.2, R337.2, SW301.4, SW301.5, SW301.6, U200.M6 (CFGBVS_0), U300.20 (VCCIO), U300.31 (VCCIO), U300.42 (VCCIO), U300.50 (VREGIN), U300.56 (VCCIO), U301.8 (VCC), X300.1 (Tri-State), X300.4 (VDD); also elsewhere on the board
/[3] Config, JTAG, Debug/+1V8_FTDI: C307.1, C308.1, C309.1, C315.1, U300.12 (VCORE), U300.37 (VCORE), U300.49 (VREGOUT), U300.64 (VCORE)
/[3] Config, JTAG, Debug/+5V_USB_B: C301.1, FB300.1, J301.1 (VBUS)
/[3] Config, JTAG, Debug/CLK_12MHZ: R338.1, X300.3 (OUT)
/[3] Config, JTAG, Debug/FTDI_EECLK: R326.1, U300.62 (EECLK), U301.2 (SCLK)
/[3] Config, JTAG, Debug/FTDI_EECS: R327.1, U300.63 (EECS), U301.1 (CS)
/[3] Config, JTAG, Debug/FTDI_EEDAT: R325.1, U300.61 (EEDATA), U301.3 (DI)
/[3] Config, JTAG, Debug/FTDI_NPOR: R333.1, U300.22 (ADBUS5)
/[3] Config, JTAG, Debug/FTDI_OSCI: R338.2, U300.2 (OSCI)
/[3] Config, JTAG, Debug/FTDI_REF: R328.2, U300.6 (REF)
/[3] Config, JTAG, Debug/FTDI_RX: R335.1, U300.39 (BDBUS1)
/[3] Config, JTAG, Debug/FTDI_RX_LED_A: D308.2 (A), R336.1
/[3] Config, JTAG, Debug/FTDI_RX_LED_K: D308.1 (K), U300.54 (BCBUS3)
/[3] Config, JTAG, Debug/FTDI_TCK: R329.1, U300.16 (ADBUS0)
/[3] Config, JTAG, Debug/FTDI_TDI: R330.1, U300.17 (ADBUS1)
/[3] Config, JTAG, Debug/FTDI_TDO: R331.1, U300.18 (ADBUS2)
/[3] Config, JTAG, Debug/FTDI_TMS: R332.1, U300.19 (ADBUS3)
/[3] Config, JTAG, Debug/FTDI_TX: R334.1, U300.38 (BDBUS0)
/[3] Config, JTAG, Debug/FTDI_TX_LED_A: D309.2 (A), R337.1
/[3] Config, JTAG, Debug/FTDI_TX_LED_K: D309.1 (K), U300.55 (BCBUS4)
/[3] Config, JTAG, Debug/FTDI_VPLL: C303.1, C304.1, FB301.2, U300.9 (VPLL)
/[3] Config, JTAG, Debug/JTAG_TCK: D303.1 (K), J300.4 (TCK), R307.2
/[3] Config, JTAG, Debug/JTAG_TDI: D301.1 (K), J300.2 (TDI), R305.2
/[3] Config, JTAG, Debug/JTAG_TDO: D302.1 (K), J300.3 (TDO), R306.2
/[3] Config, JTAG, Debug/JTAG_TMS: D304.1 (K), J300.1 (TMS), R308.2
/[3] Config, JTAG, Debug/LED_DONE_A: D300.2 (A), R309.1
/[3] Config, JTAG, Debug/LED_DONE_K: D300.1 (K), Q300.3 (D)
/[3] Config, JTAG, Debug/M0: R310.1, R311.2, SW301.1
/[3] Config, JTAG, Debug/M1: R312.1, R313.2, SW301.2
/[3] Config, JTAG, Debug/M2: R314.1, R315.2, SW301.3
/[3] Config, JTAG, Debug/M3: R316.1, R317.1, R318.2
/[3] Config, JTAG, Debug/M4: R319.1, R320.1, R321.2
/[3] Config, JTAG, Debug/NINIT: R303.2, U200.R10 (INIT_B_0)
/[3] Config, JTAG, Debug/NPROGRAM: R304.2, SW300.1, U200.L6 (PROGRAM_B_0)
/[3] Config, JTAG, Debug/TCK: R307.1, R329.2, U200.F9 (TCK_0)
/[3] Config, JTAG, Debug/TDI: R300.2, R305.1, R330.2, U200.G6 (TDI_0)
/[3] Config, JTAG, Debug/TDO: R306.1, R331.2, U200.F6 (TDO_0)
/[3] Config, JTAG, Debug/TMS: R301.2, R308.1, R332.2, U200.J6 (TMS_0)
/[3] Config, JTAG, Debug/USB_FTDI_D+: D307.1 (K), J301.3 (D+), U300.8 (DP)
/[3] Config, JTAG, Debug/USB_FTDI_D-: D306.1 (K), J301.2 (D-), U300.7 (DM)
/[3] Config, JTAG, Debug/VUSB_FILT: C302.1, D305.2 (A), FB300.2, R322.1
DONE: Q300.1 (G), R302.2, U200.R11 (DONE_0); also elsewhere on the board
FLASH_CLK_M4: R319.2
GND: C300.2, C301.2, C302.2, C303.2, C304.2, C305.2, C306.2, C307.2, C308.2, C309.2, C310.2, C311.2, C312.2, C313.2, C314.2, C315.2, C316.2, C318.2, D301.2 (A), D302.2 (A), D303.2 (A), D304.2 (A), D306.2 (A), D307.2 (A), J300.5 (GND), J301.5 (GND), Q300.2 (S), R311.1, R313.1, R315.1, R318.1, R321.1, R323.2, R328.1, SW300.2, U200.K9 (VP_0), U200.K10 (VREFN_0), U200.L9 (VREFP_0), U200.L10 (VN_0), U200.M9 (DXP_0), U200.M10 (DXN_0), U300.1 (GND), U300.5 (GND), U300.10 (AGND), U300.11 (GND), U300.13 (TEST), U300.15 (GND), U300.25 (GND), U300.35 (GND), U300.47 (GND), U300.51 (GND), U301.5 (GND), X300.2 (GND); also elsewhere on the board
GNDPWR: J301.6 (Shield); also elsewhere on the board
unnamed: C305.1, C306.1, FB302.2, U300.4 (VPHY)
unnamed: R322.2, R323.1, U300.14 (~RESET)
unnamed: R324.1, R325.2, U301.4 (DO)
PS_NPOR: R333.2; also elsewhere on the board
QSPI_DQ0_M3: R316.2; also elsewhere on the board
QSPI_DQ1_M1: R312.2; also elsewhere on the board
QSPI_DQ2_M2: R314.2; also elsewhere on the board
QSPI_DQ3_M0: R310.2; also elsewhere on the board
UART1_RX: R334.2; also elsewhere on the board
UART1_TX_VCFG1: R335.2; also elsewhere on the board
VCC: D305.1 (K); also elsewhere on the board

Notes on the sheet:
CFGBVS=1 -> VCC0=3V3 VP=VN=GND -> Not Used VREFP=VREFN=GND -> On-chip ref
M4 -> PLL Bypass
M3 -> JTAG Cascade/Independent Mode
[2] Zynq Config, JTAG, Debug
M[0 2 1]=Boot Mode
Boot Mode MIO Strapping Pins (Zynq TRM p167)
Zynq Config, JTAG
FTDI JTAG Programmer and USB-to-UART

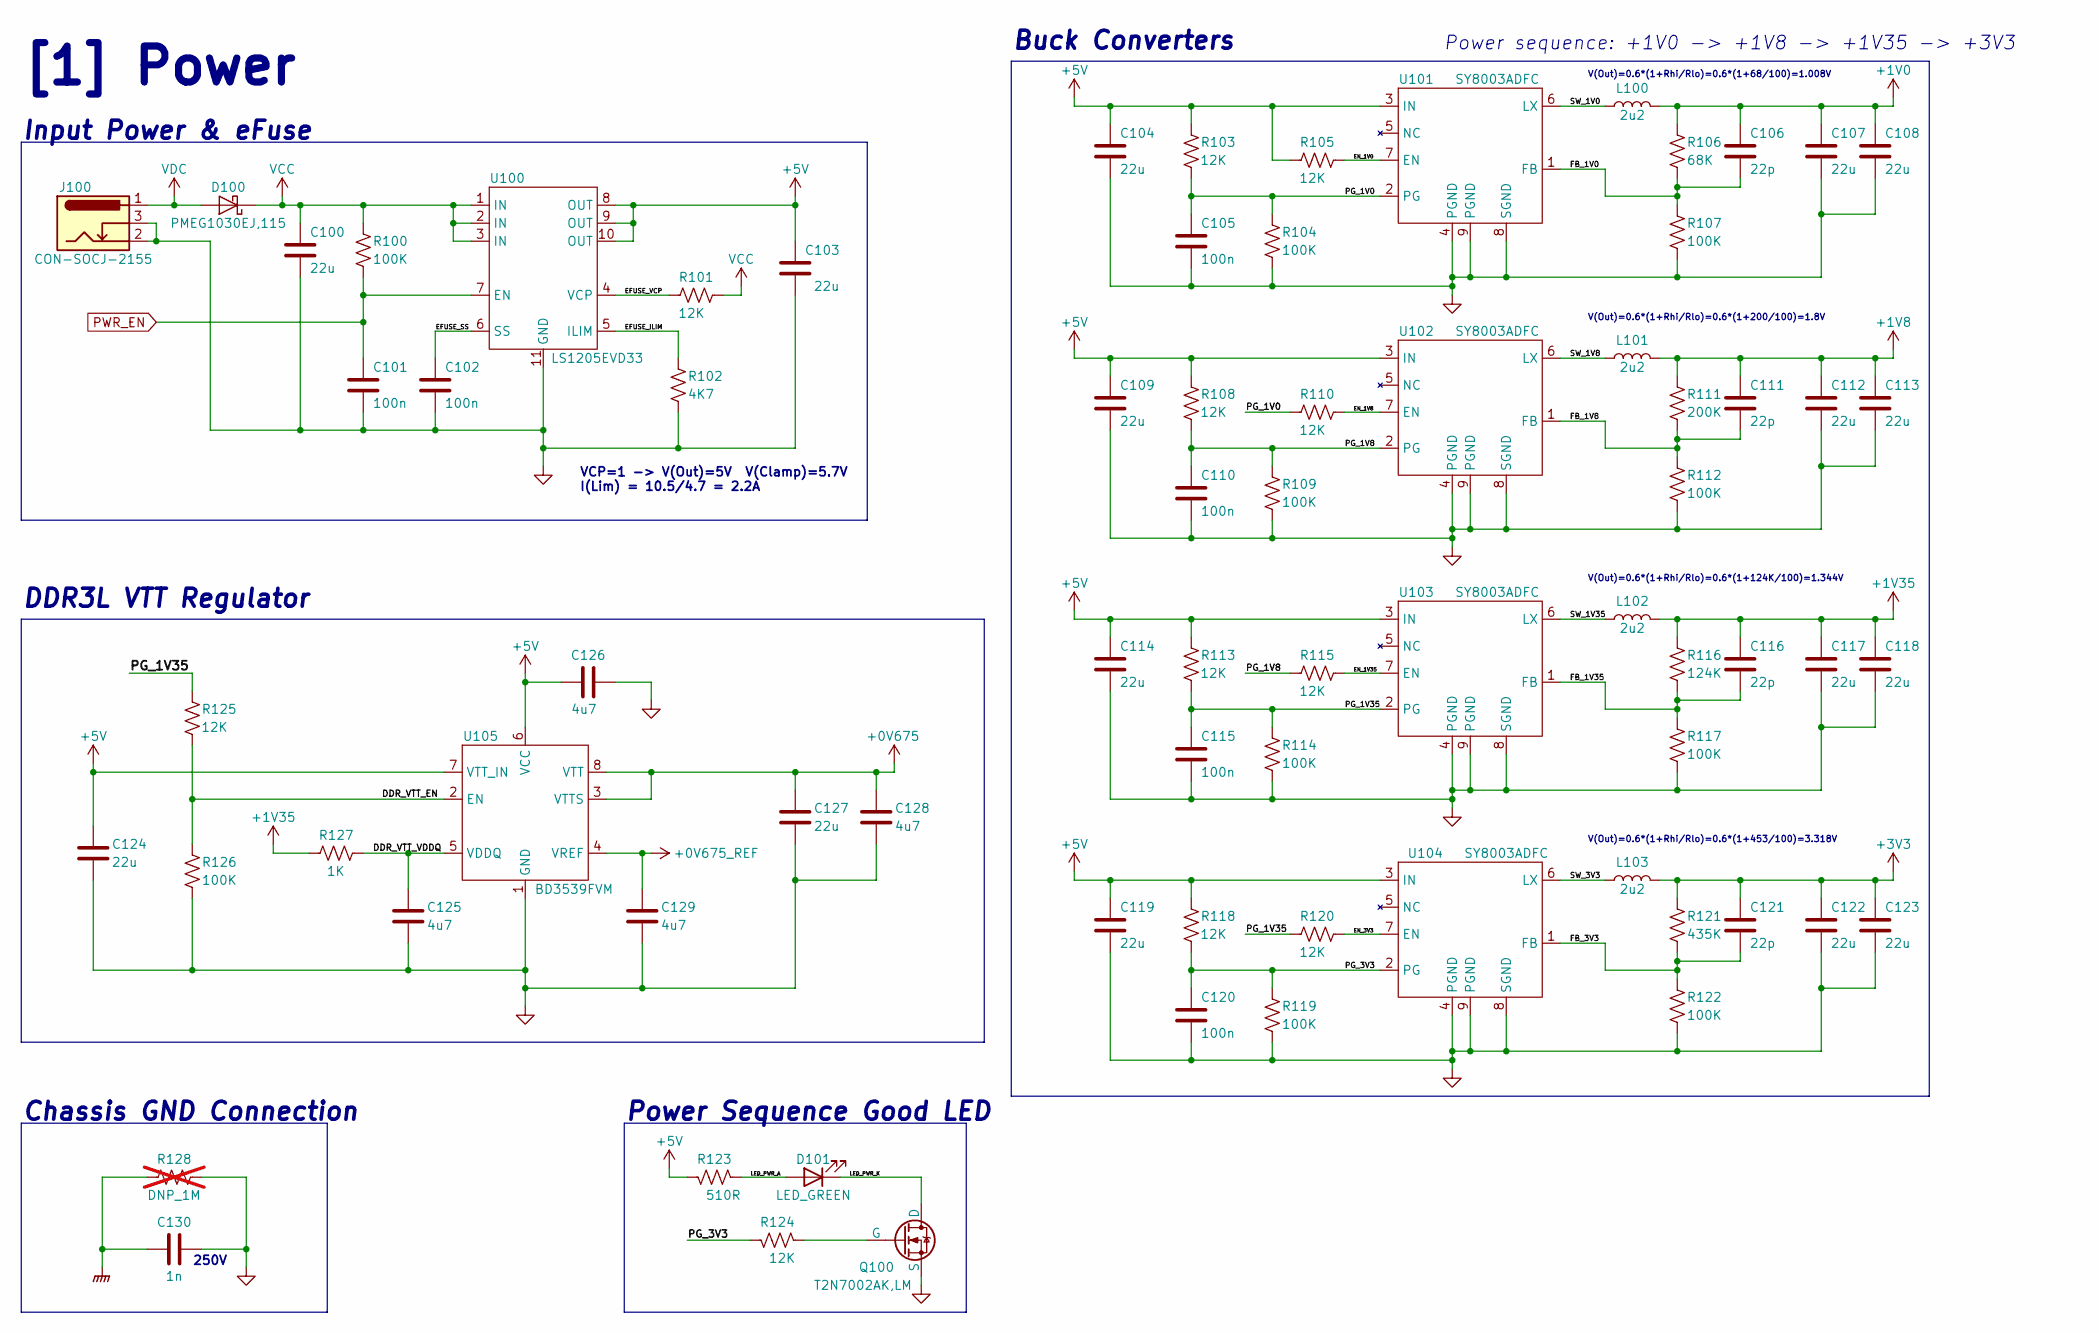
[picture p22: schematic Power.kicad_sch, Power Supplies]

Parts:
C100, C103, C104, C107, C108, C109, C112, C113, C114, C117, C118, C119, C122, C123, C124, C127: 22u; C_1210_3225Metric; Manufacturer PN CL32A226MOJNNNE; LCSC PN C100086
C101, C102, C105, C110, C115, C120: 100n; C_0402_1005Metric; Manufacturer PN CC0402KRX5R8BB104; LCSC PN C106256
C106, C111, C116, C121: 22p; C_0402_1005Metric; Manufacturer PN GCM1555C1H220JA16D; LCSC PN C126502
C125, C126, C128, C129: 4u7; C_0402_1005Metric; Manufacturer PN CL05A475MP5NRNC; LCSC PN C23733
C130: 1n; C_1206_3216Metric; Manufacturer PN 202R18W102KV4E; LCSC PN C173242
D100: PMEG1030EJ,115; D_SOD-323F; Manufacturer PN PMEG1030EJ,115; LCSC PN C133633
D101: LED_GREEN; LED_0402_1005Metric; Manufacturer PN SZYY0402YG; LCSC PN C434449
J100: CON-SOCJ-2155; GRAVITECH_CON-SOCJ-2155; Manufacturer PN CON-SOCJ-2155
L100, L101, L102, L103: 2u2; L_Taiyo-Yuden_NR-60xx; Manufacturer PN NR6028T2R2N
Q100: T2N7002AK,LM; SOT23_TOS; Manufacturer PN T2N7002AK,LM; LCSC PN C516175
R100, R104, R107, R109, R112, R114, R117, R119, R122, R126: 100K; R_0402_1005Metric; Manufacturer PN RC0402FR-07100KL; LCSC PN C60491
R101, R103, R105, R108, R110, R113, R115, R118, R120, R124, R125: 12K; R_0402_1005Metric; Manufacturer PN RTT021202FTH; LCSC PN C102781
R102: 4K7; R_0402_1005Metric; Manufacturer PN RC0402FR-074K7L; LCSC PN C105871
R106: 68K; R_0402_1005Metric; Manufacturer PN RC0402FR-0768KL; LCSC PN C137947
R111: 200K; R_0402_1005Metric; Manufacturer PN RC0402FR-07200KL; LCSC PN C114763
R116: 124K; R_0402_1005Metric; Manufacturer PN RC0402FR-07124KL; LCSC PN C138062
R121: 435K; R_0402_1005Metric; Manufacturer PN RC0402FR-07453KL; LCSC PN C137978
R123: 510R; R_0402_1005Metric; Manufacturer PN RC0402FR-07510RL; LCSC PN C276273
R127: 1K; R_0402_1005Metric; Manufacturer PN RC0402FR-071KL; LCSC PN C106235
R128: DNP_1M; R_1206_3216Metric; not fitted
U100: LS1205EVD33; DFN-10-1EP_3x3mm_P0.5mm_EP1.55x2.48mm; Manufacturer PN LS1205EVD33
U101, U102, U103, U104: SY8003ADFC; DFN-8-1EP_2x2mm_P0.5mm_EP1.05x1.75mm; Manufacturer PN SY8003ADFC; LCSC PN C178236
U105: BD3539FVM; MSOP-8_3x3mm_P0.65mm; Manufacturer PN BD3539FVM-TR; LCSC PN C213437

Connections:
+0V675: C127.1, C128.1, U105.3 (VTTS), U105.8 (VTT); also elsewhere on the board
+0V675_REF: C129.1, U105.4 (VREF); also elsewhere on the board
+1V0: C106.1, C107.1, C108.1, L100.2, R106.1; also elsewhere on the board
+1V8: C111.1, C112.1, C113.1, L101.2, R111.1; also elsewhere on the board
+1V35: C116.1, C117.1, C118.1, L102.2, R116.1, R127.1; also elsewhere on the board
+3V3: C121.1, C122.1, C123.1, L103.2, R121.1; also elsewhere on the board
+5V: C103.1, C104.1, C109.1, C114.1, C119.1, C124.1, C126.1, R103.2, R105.1, R108.2, R113.2, R118.2, R123.2, U100.8 (OUT), U100.9 (OUT), U100.10 (OUT), U101.3 (IN), U102.3 (IN), U103.3 (IN), U104.3 (IN), U105.6 (VCC), U105.7 (VTT_IN); also elsewhere on the board
/[1] Power/DDR_VTT_EN: R125.1, R126.1, U105.2 (EN)
/[1] Power/DDR_VTT_VDDQ: C125.1, R127.2, U105.5 (VDDQ)
/[1] Power/EFUSE_ILIM: R102.1, U100.5 (ILIM)
/[1] Power/EFUSE_SS: C102.1, U100.6 (SS)
/[1] Power/EFUSE_VCP: R101.1, U100.4 (VCP)
/[1] Power/EN_1V0: R105.2, U101.7 (EN)
/[1] Power/EN_1V8: R110.2, U102.7 (EN)
/[1] Power/EN_1V35: R115.2, U103.7 (EN)
/[1] Power/EN_3V3: R120.2, U104.7 (EN)
/[1] Power/FB_1V0: C106.2, R106.2, R107.1, U101.1 (FB)
/[1] Power/FB_1V8: C111.2, R111.2, R112.1, U102.1 (FB)
/[1] Power/FB_1V35: C116.2, R116.2, R117.1, U103.1 (FB)
/[1] Power/FB_3V3: C121.2, R121.2, R122.1, U104.1 (FB)
/[1] Power/LED_PWR_A: D101.2 (A), R123.1
/[1] Power/LED_PWR_K: D101.1 (K), Q100.3 (D)
/[1] Power/PG_1V0: C105.1, R103.1, R104.1, R110.1, U101.2 (PG)
/[1] Power/PG_1V8: C110.1, R108.1, R109.1, R115.1, U102.2 (PG)
/[1] Power/PG_1V35: C115.1, R113.1, R114.1, R120.1, R125.2, U103.2 (PG)
/[1] Power/PG_3V3: C120.1, R118.1, R119.1, R124.2, U104.2 (PG)
/[1] Power/SW_1V0: L100.1, U101.6 (LX)
/[1] Power/SW_1V8: L101.1, U102.6 (LX)
/[1] Power/SW_1V35: L102.1, U103.6 (LX)
/[1] Power/SW_3V3: L103.1, U104.6 (LX)
GND: C100.2, C101.2, C102.2, C103.2, C104.2, C105.2, C107.2, C108.2, C109.2, C110.2, C112.2, C113.2, C114.2, C115.2, C117.2, C118.2, C119.2, C120.2, C122.2, C123.2, C124.2, C125.2, C126.2, C127.2, C128.2, C129.2, C130.2, J100.2, J100.3, Q100.2 (S), R102.2, R104.2, R107.2, R109.2, R112.2, R114.2, R117.2, R119.2, R122.2, R126.2, R128.2, U100.11 (GND), U101.4 (PGND), U101.8 (SGND), U101.9 (PGND), U102.4 (PGND), U102.8 (SGND), U102.9 (PGND), U103.4 (PGND), U103.8 (SGND), U103.9 (PGND), U104.4 (PGND), U104.8 (SGND), U104.9 (PGND), U105.1 (GND); also elsewhere on the board
GNDPWR: C130.1, R128.1; also elsewhere on the board
unnamed: Q100.1 (G), R124.1
PWR_EN: C101.1, R100.2, U100.7 (EN); also elsewhere on the board
VCC: C100.1, D100.1 (K), R100.1, R101.2, U100.1 (IN), U100.2 (IN), U100.3 (IN); also elsewhere on the board
VDC: D100.2 (A), J100.1

Notes on the sheet:
VCP=1 -> V(Out)=5V V(Clamp)=5.7V I(Lim) = 10.5/4.7 = 2.2A
V(Out)=0.6*(1+Rhi/Rlo)=0.6*(1+68/100)=1.008V
V(Out)=0.6*(1+Rhi/Rlo)=0.6*(1+200/100)=1.8V
V(Out)=0.6*(1+Rhi/Rlo)=0.6*(1+453/100)=3.318V
Power sequence: +1V0 -> +1V8 -> +1V35 -> +3V3
[1] Power
DDR3L VTT Regulator
Chassis GND Connection
Input Power & eFuse
Power Sequence Good LED
V(Out)=0.6*(1+Rhi/Rlo)=0.6*(1+124K/100)=1.344V
Buck Converters
250V

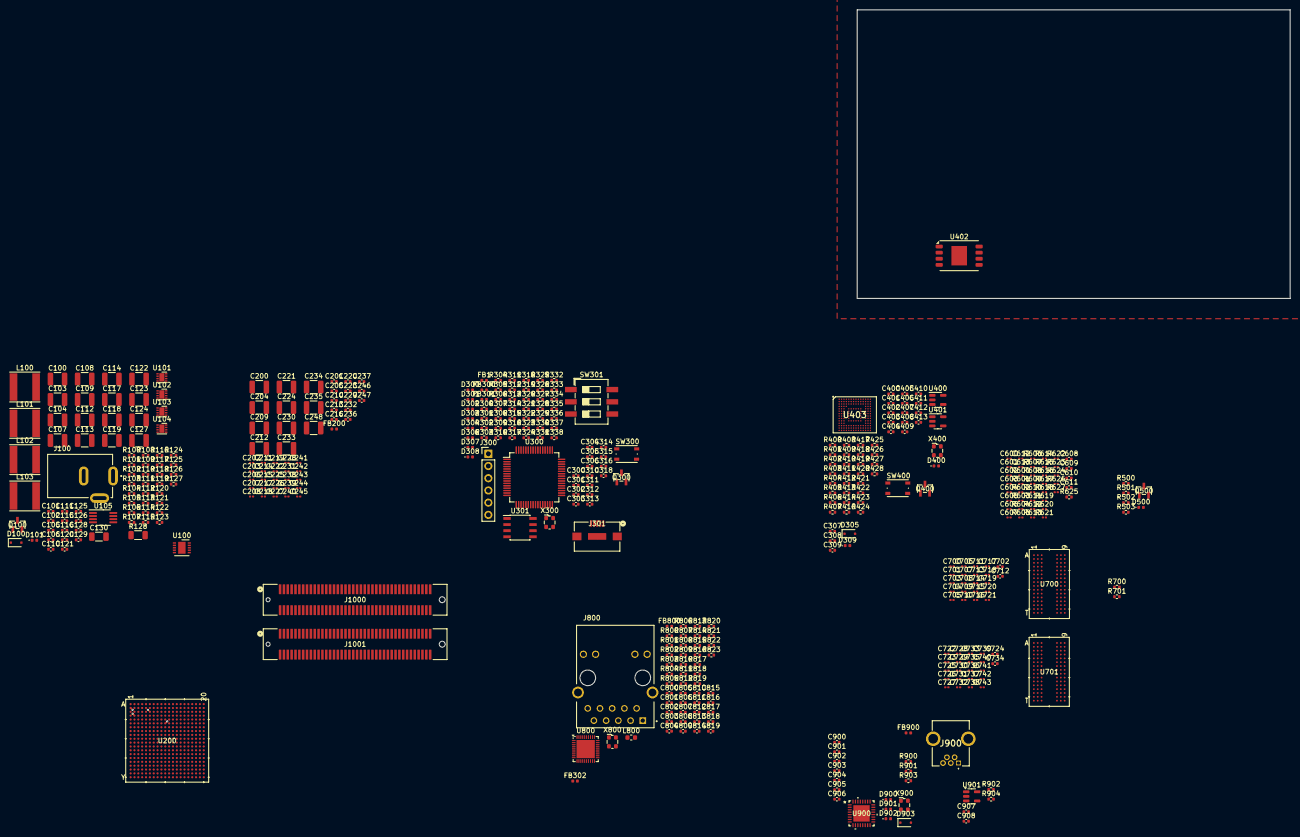
[picture p23: board ZeBra-X.kicad_pcb from above]

Board: 10 copper layers, 90.0 x 60.0 mm, 424 parts (0 on the bottom side), 319 nets.
