Dylanfg123/Zebra-X/(commit log)

2023-12-10 Page 1 Power schematic done
    [CON-SOCJ-2155--3DModel-STEP-56544.STEP, Power.kicad_sch, ZeBra-X.kicad_pcb, ZeBra-X.kicad_sch]
2023-12-10 Schematic page 2 done, Zynq Power
    [CLG400_XIL.step, Power.kicad_sch, ZeBra-X.kicad_pcb, ZeBra-X.kicad_sch, Zynq_Power.kicad_sch]
2023-12-14 Fixed Q100 footprint
    [Power.kicad_sch]
2023-12-18 Finished page 3 of schematic: Zynq Config, JTAG, Debug
    [Config_JTAG_Debug.kicad_sch, Power.kicad_sch, ZeBra-X.kicad_sch, Zynq_Power.kicad_sch]
2024-01-27 Finished schematic page 4: Zynq Processing System (PS), includes 128MBit QSPI flash, 33.33 MHz PS Clock, and 4Gbyte EMMC Memory
    [Config_JTAG_Debug.kicad_sch, S40FC004C1B2C00000.stp, ZeBra-X.kicad_pcb, ZeBra-X.kicad_sch, Zynq_Power.kicad_sch, Zynq_Processing_System.kicad_sch]
2024-01-28 Added shematic sheet 5:Zynq Programmable Logic (PL)
    [Config_JTAG_Debug.kicad_sch, ZeBra-X.kicad_sch, Zynq_Power.kicad_sch, Zynq_Processing_System.kicad_sch, Zynq_Programmable_Logic.kicad_sch]
2024-01-28 Finished schematic page 6:Zynq DDR Interface & Termination
    [Config_JTAG_Debug.kicad_sch, ZeBra-X.kicad_sch, Zynq_DDR_Interface_Termination.kicad_sch, Zynq_Power.kicad_sch, Zynq_Processing_System.kicad_sch, Zynq_Programmable_Logic.kicad_sch]
2024-08-24 Added page '[7] 1GB DDR3L Modules'
    [Config_JTAG_Debug.kicad_sch, DDR3L_Modules.kicad_sch, FBGA96_TW_MRN.step, Power.kicad_sch, ZeBra-X.kicad_pcb, ZeBra-X.kicad_sch, Zynq_DDR_Interface_Termination.kicad_sch, Zynq_Power.kicad_sch]
2024-08-24 Added placeholders for sheets 8,9, and 10
    [DDR3L_Modules.kicad_sch, Gigabit_Ethernet.kicad_sch, Mezzanine_conn.kicad_sch, USB_2.0_HS.kicad_sch, ZeBra-X.kicad_sch]
2025-01-18 Completed page 8, Gigabit Ethernet Controller
    [Config_JTAG_Debug.kicad_sch, DDR3L_Modules.kicad_sch, Gigabit_Ethernet.kicad_sch, HR911130A.step, Mezzanine_conn.kicad_sch, USB_2.0_HS.kicad_sch, ZeBra-X.kicad_pcb, ZeBra-X.kicad_sch]
2025-01-18 started page 9, USB2.0 hub
    [Gigabit_Ethernet.kicad_sch, QFN32_5X5MC_MCH.step, USB_2.0_HS.kicad_sch]
2025-01-19 finished page 9, USB 2.0 Hub
    [GMSB0522132EU.stp, USB_2.0_HS.kicad_sch, ZeBra-X.kicad_pcb]
2025-01-22 Finished first pass of schematic, needs netclass assignments and double check
    [10144518-082x0xxx.stp, Config_JTAG_Debug.kicad_sch, Mezzanine_conn.kicad_sch, Power.kicad_sch, ZeBra-X.kicad_pcb, ZeBra-X.kicad_sch, Zynq_DDR_Interface_Termination.kicad_sch, Zynq_Power.kicad_sch]
